bostang/PSoC6/README.md

# PSoC6
 Repository untuk program yang dijalankan pada PSoC6 (belajar dan hands-on project)

## Pranala Penting

[Hardware Abstraction Layer (HAL)](https://infineon.github.io/psoc6hal/html/index.html)
