bostang/PSoC6/Notes/1.md

1. Untuk membantu mempelajari konsep pemrograman PSoC, kita bisa bisa juga membaca file-file yang ada yang secara otomatis terbentuk / di example

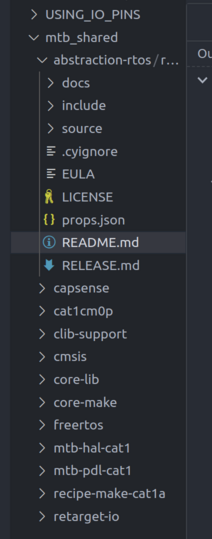
[picture p18: Notes/image/1/1701488007020.png]
direktori projek


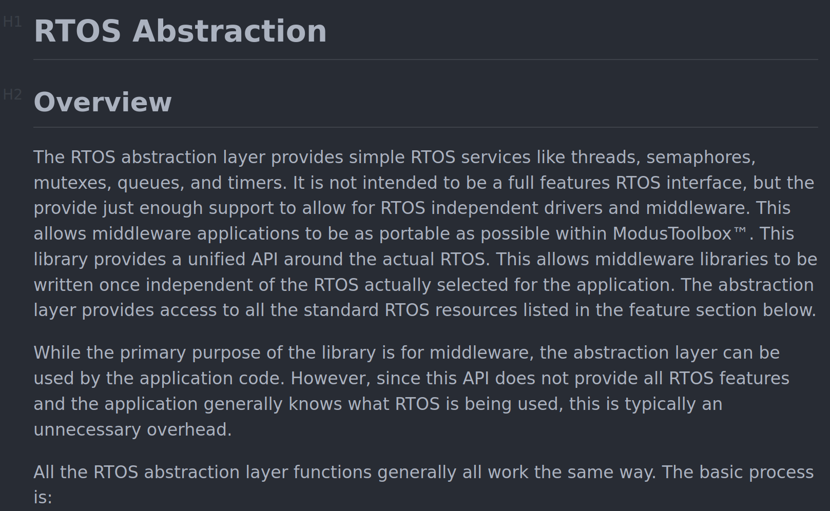
[picture p19: Notes/image/1/1701488026996.png]
README.md dari salah satu folder yang terbentuk


2. sedikit trick untuk convert size image : `

```
convert -resize 20% source.png dest.jpg
```

3. workflow yang lumayan efektif

ketika melihat dokumen-dokumen seperti user-manual, lebih enak diilihat di pdf viewer di VScode ketimbang di browser --> kebanyakan tab dan harus buka **My documents** dulu untuk ngebuka pdfnya.

4. Cara cepat untuk build sekaligus flash program ke PSoC

Pada direktori (_workspace_) yang dibuat, buka terminal lalu ketikkan:
```
make program
```
5. Dalam melakukan pengembangan kode, upayakan untuk menggunakan `MACRO`. Usahakan tidak ada angka pada tengah-tengah kode. Deklarasikan semua `MACRO` di awal.

6. Pengembangan kode dengan PSoC memiliki alur kembangkan dari _example_ yang ada, sesuaikan dengan kebutuhan kita berdasarkan referensi [HAL API](https://infineon.github.io/psoc6hal/html/index.html) dan gunakan bantuan [ChatGPT](chat.openai.com/chat) agar proses pengembangan lebih efektif dan mengurangi kebingunan.

7. _common pattern_ yang diamati untuk melakukan suatu proses sambil error handling
```
    if (CY_RSLT_SUCCESS == <PROSES>)
    {
        handle_error();
    }
```
contoh :
```
if (CY_RSLT_SUCCESS == cyhal_uart_getc(&cy_retarget_io_uart_obj, &read_data, 0))
    if (result != CY_RSLT_SUCCESS)
    {
        handle_error();
    }
```

8. selalu melakukan _error handling_ ketika inisiasi
```
result = cybsp_init();
if (result != CY_RSLT_SUCCESS)
{
    handle_error();
}

result = cyhal_uart_init(&uart_obj_barcode, pin_barcode_tx, pin_barcode_rx,NC,NC, NULL, NULL);
if (result != CY_RSLT_SUCCESS)
{
    handle_error();
}
```
9. Apabila melakukan _development_ di Eclipse IDE (windows), Untuk menggunakan terminal, kita tidak perlu menggunakan aplikasi eksternal seperty Putty ataupun TeraTerm, tetapi bisa menggunakan terminal yang ada di Modus toolbox sendiri.

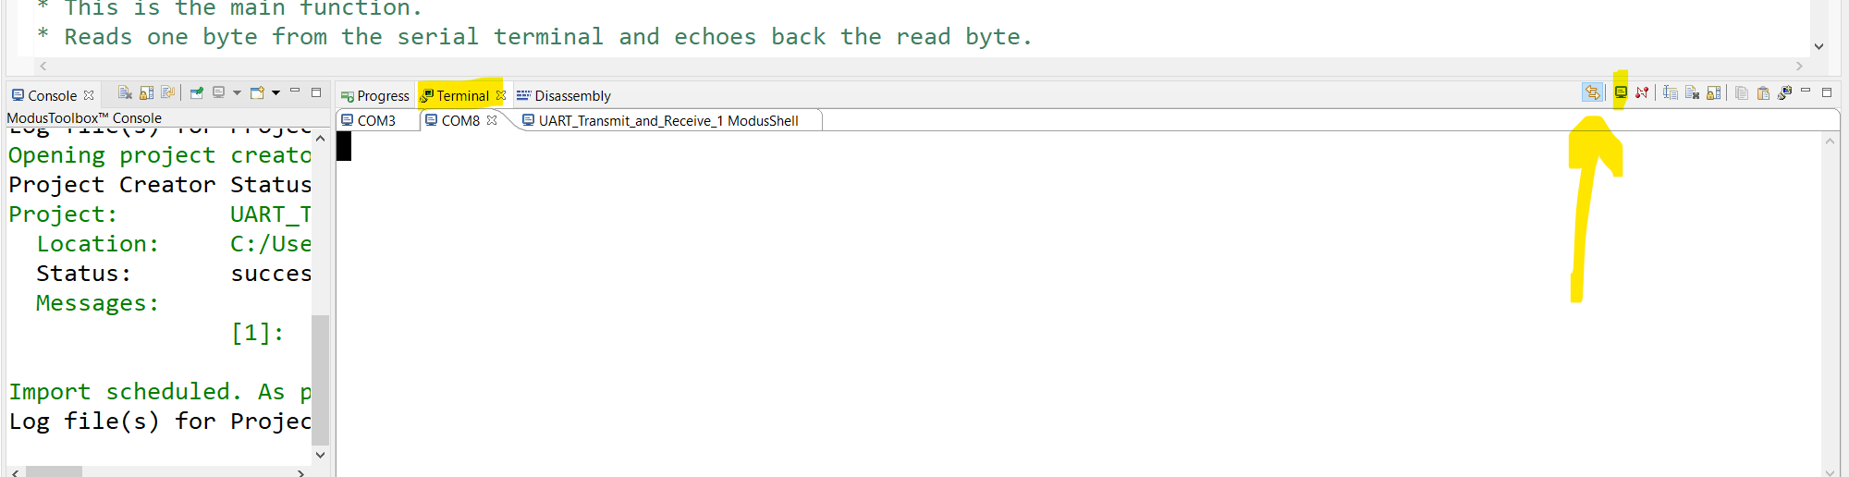
[picture p20: Notes/image/1/prompt_terminal_modus_toolbox.png]
Foto terminal MTB
