bostang/PSoC6/Development/YR903_RFID_module_dev/images/host_packet_definition.png

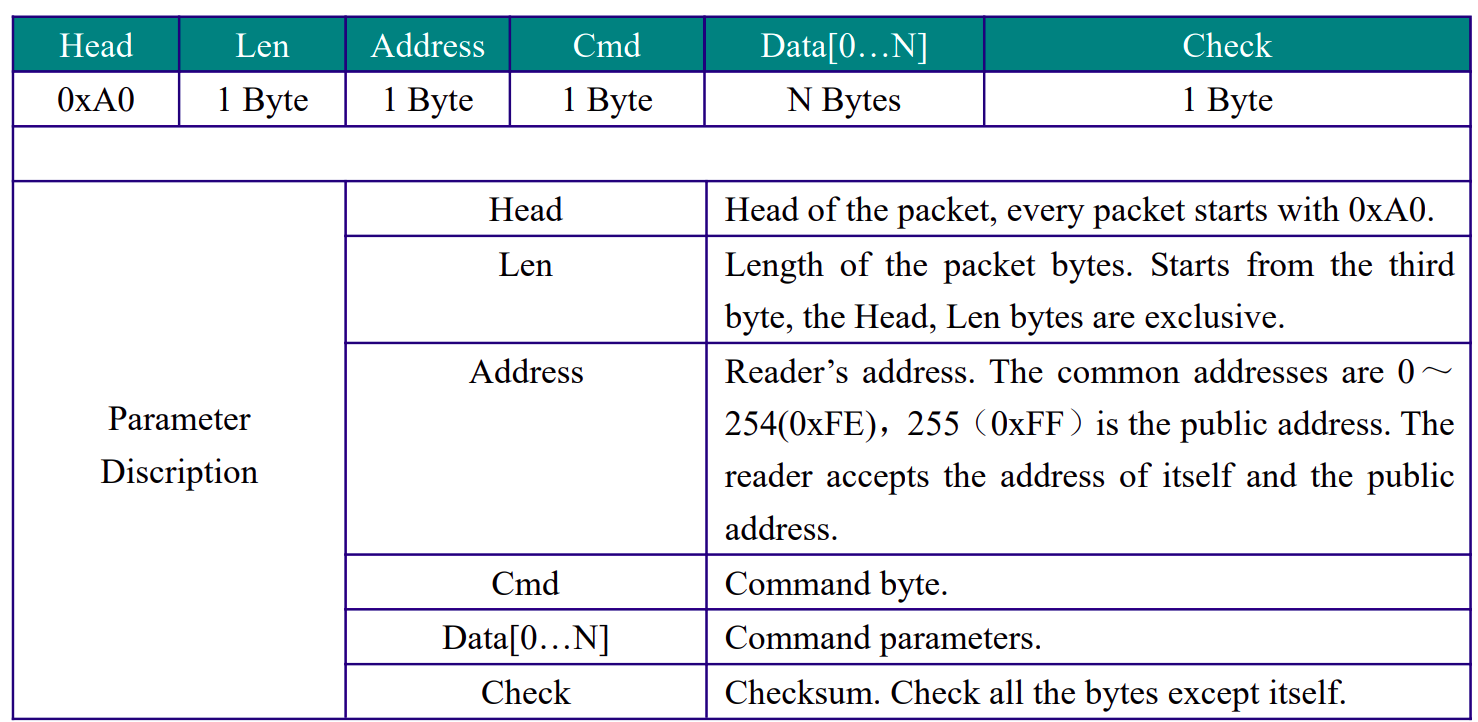
Development/YR903_RFID_module_dev/images/host_packet_definition.png
