bostang/PSoC6/Development/YR903_RFID_module_dev/images/response_packet_definition.png

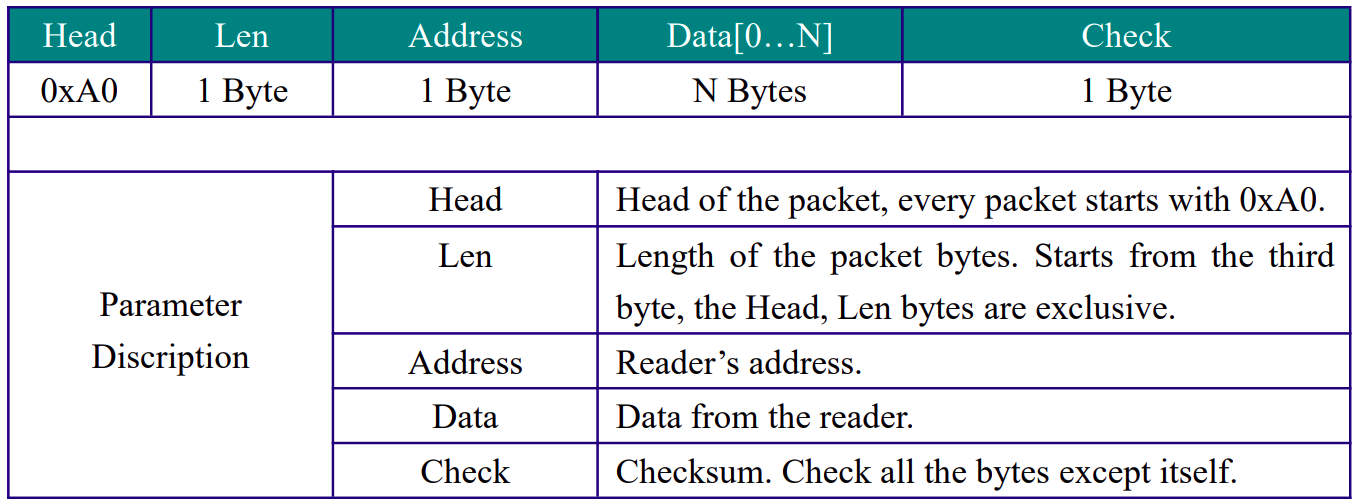
Development/YR903_RFID_module_dev/images/response_packet_definition.png
