bostang/PSoC6/Development/YR903_RFID_module_dev/images/sukses_kirim_ke_terminal.png

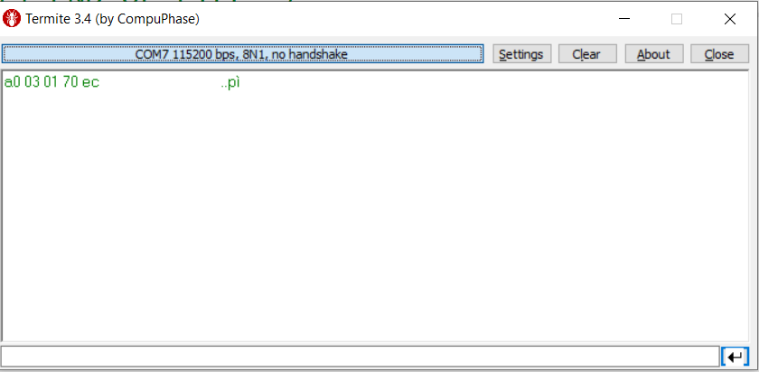
Development/YR903_RFID_module_dev/images/sukses_kirim_ke_terminal.png
