bostang/PSoC6/PCB/3d models/Button Cap Front.png

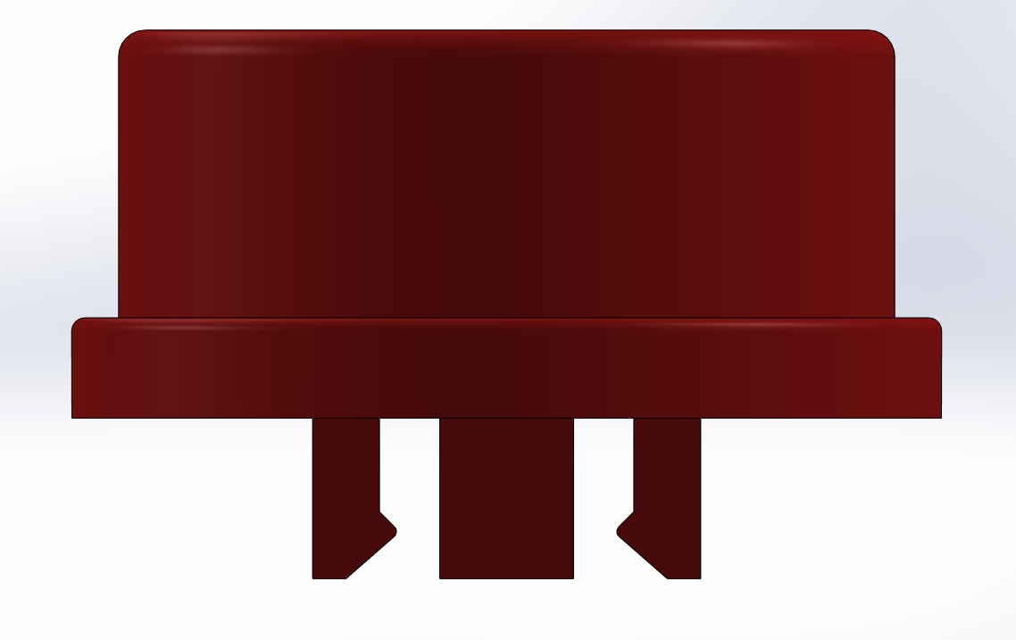
PCB/3d models/Button Cap Front.png
