bostang/PSoC6/PCB/3d models/Button Cap Isometric.png

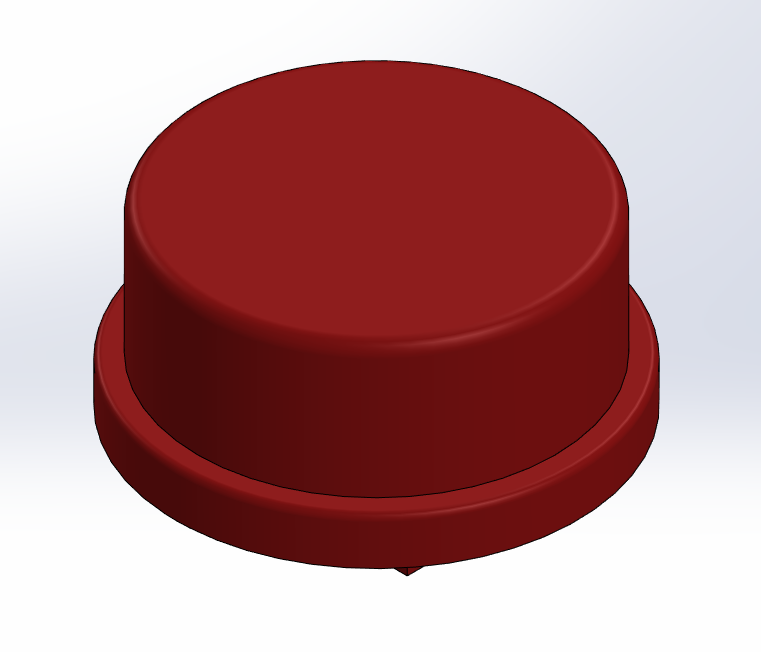
PCB/3d models/Button Cap Isometric.png
