bostang/PSoC6/PCB/3d models/Button Cap Side.png

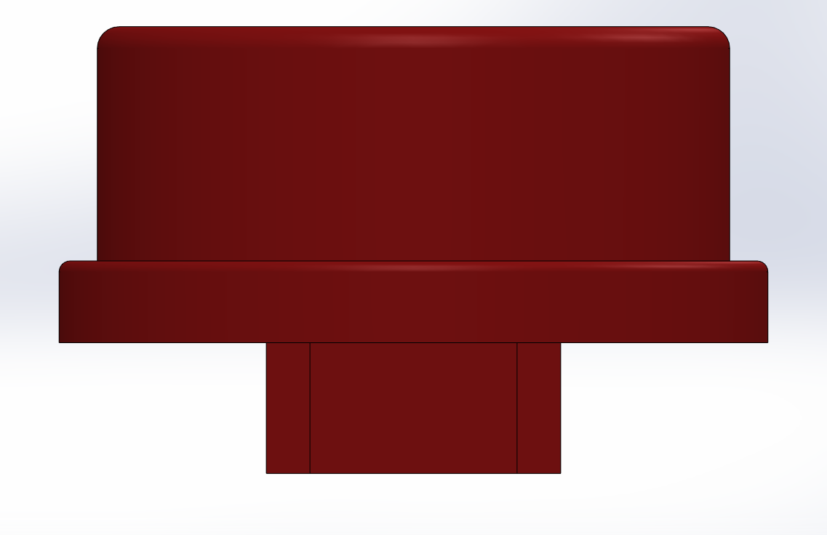
PCB/3d models/Button Cap Side.png
