bostang/PSoC6/PCB/3d models/Button Front.png

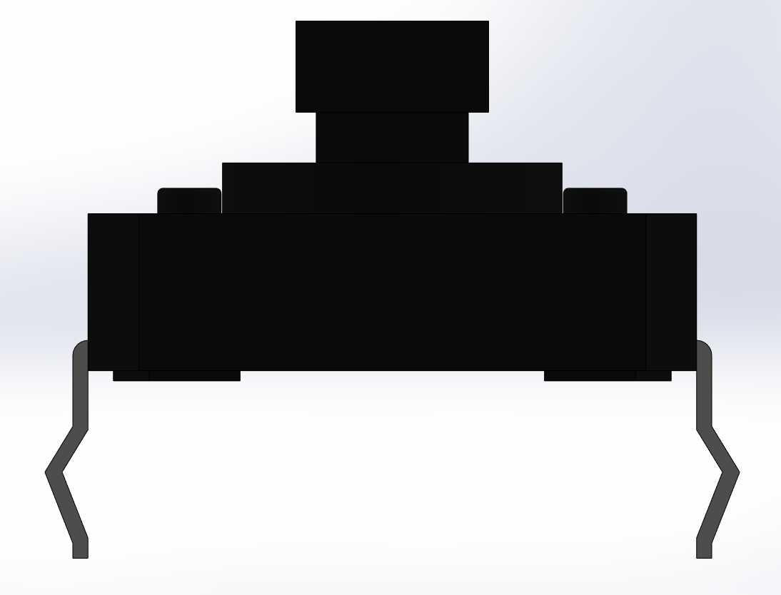
PCB/3d models/Button Front.png
