bostang/PSoC6/PCB/3d models/Button Isometric.png

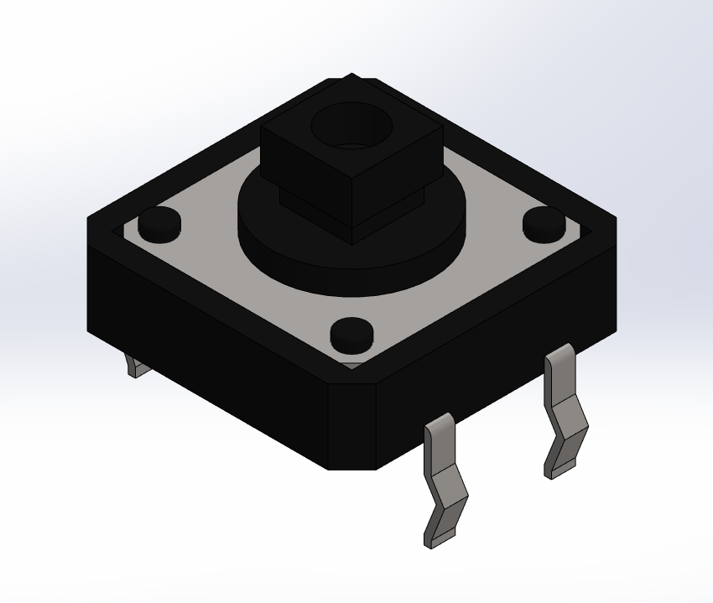
PCB/3d models/Button Isometric.png
