bostang/PSoC6/PCB/3d models/Button Side.png

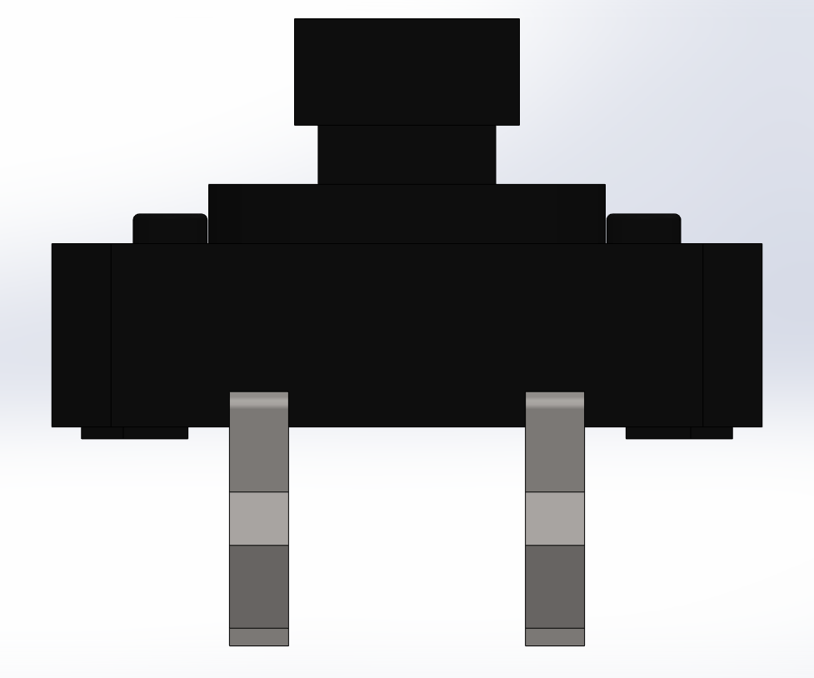
PCB/3d models/Button Side.png
