bostang/PSoC6/PCB/3d models/Button with Cap Front.png

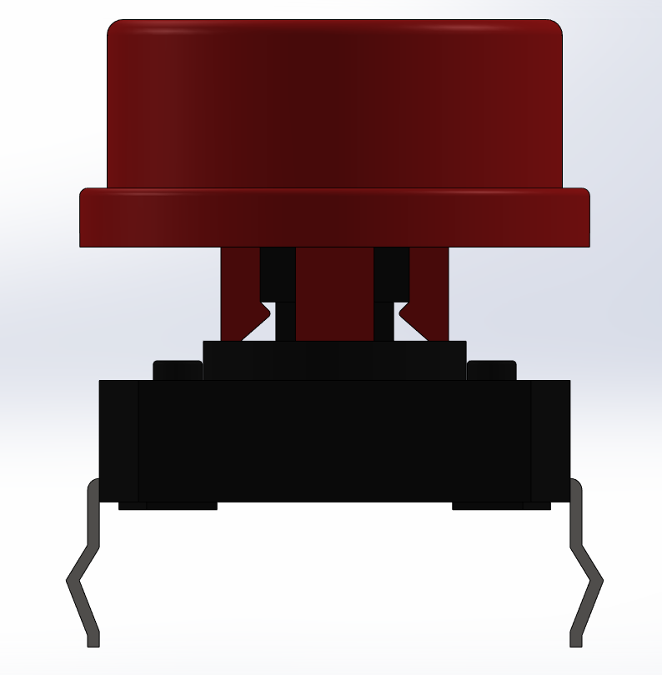
PCB/3d models/Button with Cap Front.png
