bostang/PSoC6/PCB/3d models/Button with Cap Side.png

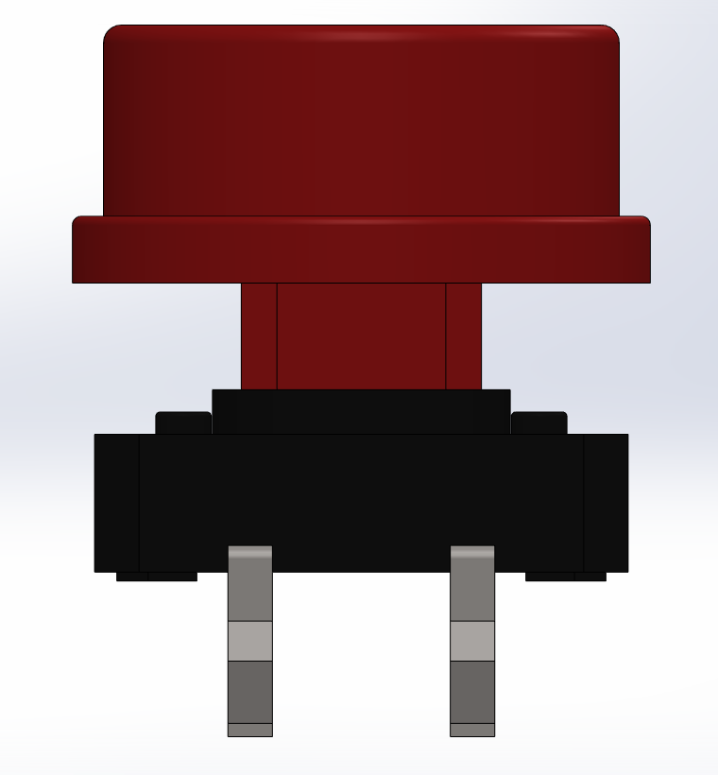
PCB/3d models/Button with Cap Side.png
