bostang/PSoC6/PCB/img/stei-itb.jpeg

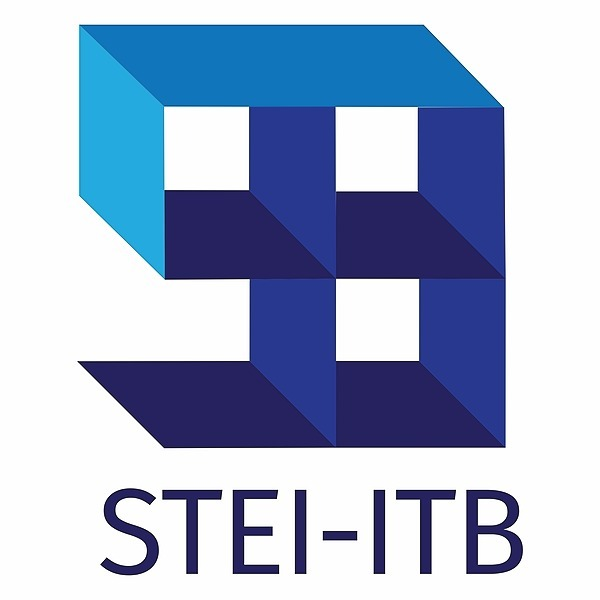
PCB/img/stei-itb.jpeg
