bostang/PSoC6/PCB/3d models/BMxxB-SRSR-TB/BM02B-SRSS-TB.STEP

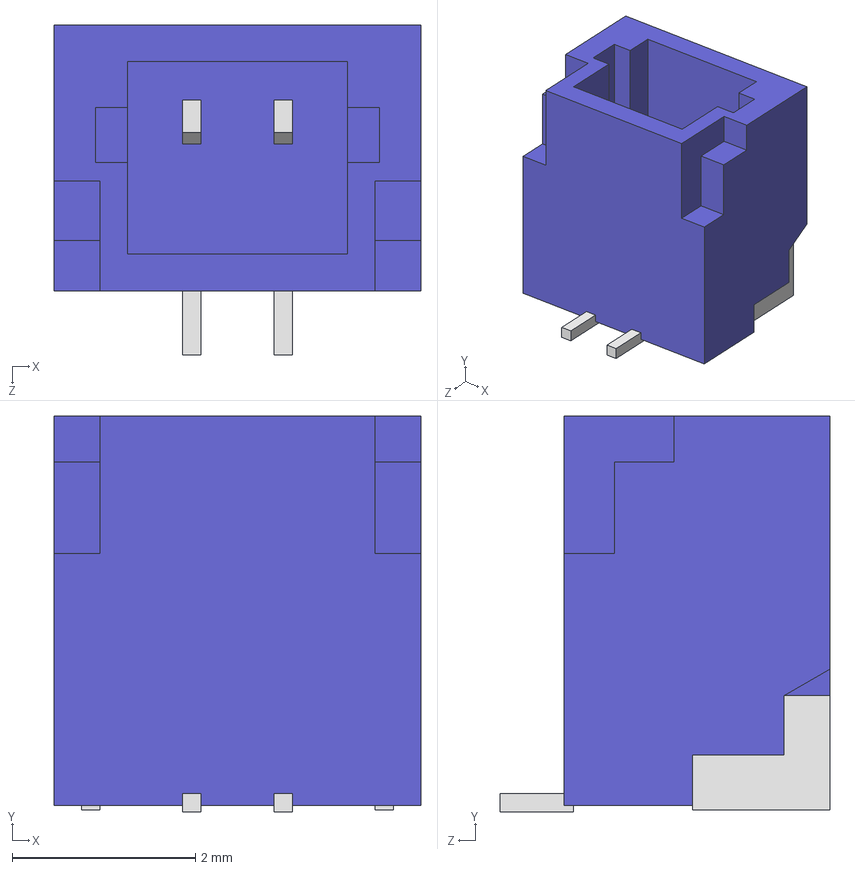
[picture p33: CAD file, 2024-04-19]
PCB/3d models/BMxxB-SRSR-TB/BM02B-SRSS-TB.STEP
4.00 x 4.32 x 3.60 mm
