bostang/PSoC6/PCB/3d models/FFC/2-1734592-0.stp

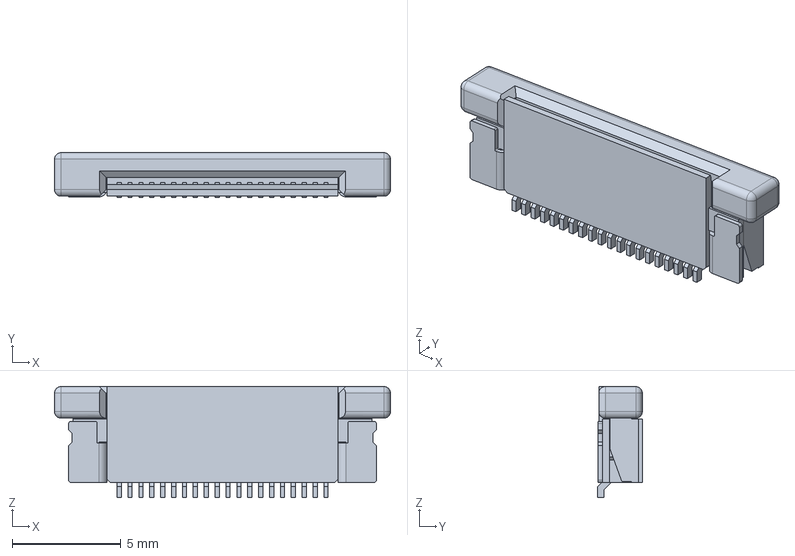
[picture p34: CAD file, 2024-04-19]
PCB/3d models/FFC/2-1734592-0.stp
15.4 x 2.05 x 5.11 mm
