bostang/PSoC6/PCB/3d models/FreeCAD Files/Set.FCStd

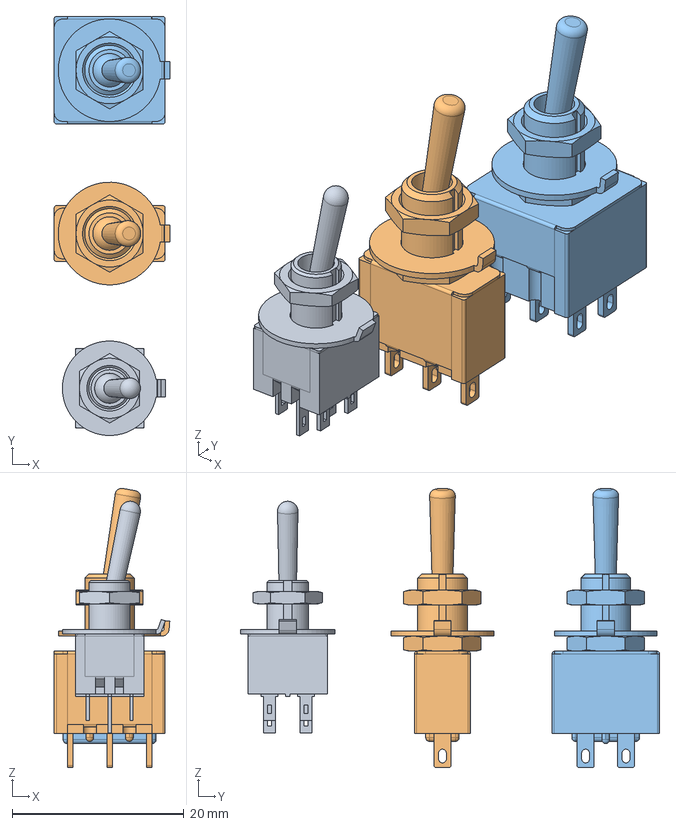
[picture p35: CAD file, 2024-04-19]
PCB/3d models/FreeCAD Files/Set.FCStd
13.4 x 48.7 x 32.5 mm
5mm DPDT Mini Toggle Switch_001
6mm SPDT Mini Toggle Switch_001
6mm DPDT Mini Toggle Switch_001
