bostang/PSoC6/PCB/3d models/SMxxB-SRSS-TB/SM12B-SRSS-TB.STEP

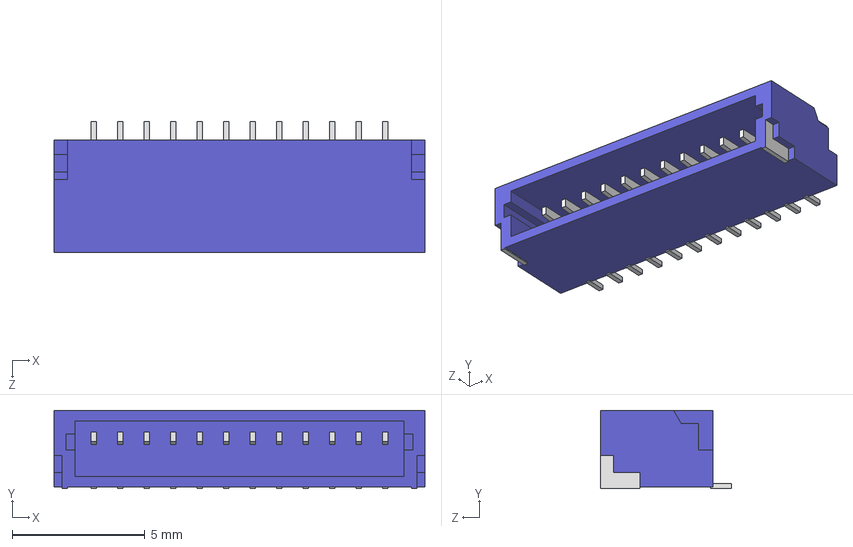
[picture p38: CAD file, 2024-04-19]
PCB/3d models/SMxxB-SRSS-TB/SM12B-SRSS-TB.STEP
14.0 x 2.96 x 4.95 mm
