bostang/PSoC6/PCB/3d models/SSH-003T-P0.2-H/SSH-003T-P0.2-H.STEP

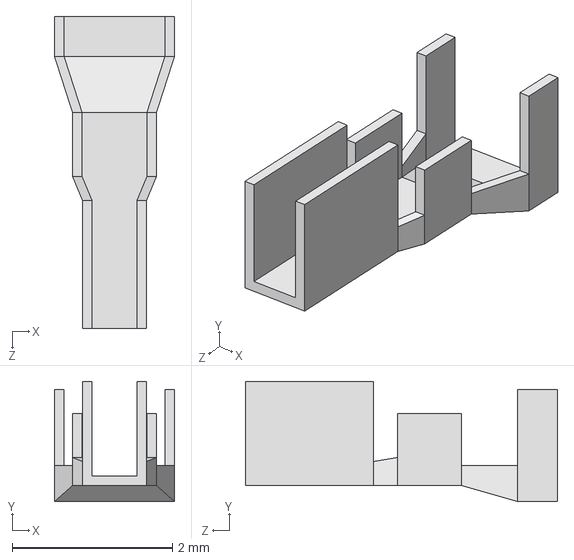
[picture p39: CAD file, 2024-04-19]
PCB/3d models/SSH-003T-P0.2-H/SSH-003T-P0.2-H.STEP
1.50 x 1.50 x 3.90 mm
