bostang/PSoC6/PCB/3d models/BMxxB-SRSR-TB/BM08B-SRSS-TB.STEP

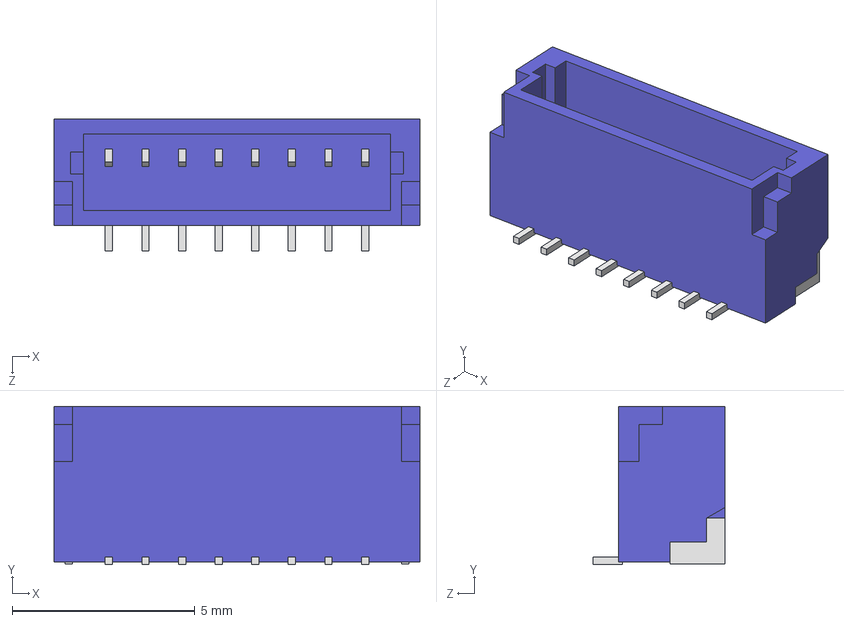
[picture p40: CAD file, 2024-04-19]
PCB/3d models/BMxxB-SRSR-TB/BM08B-SRSS-TB.STEP
10.0 x 4.32 x 3.60 mm
