bostang/PSoC6/PCB/3d models/SHR-xxV-S-B/SHR-06V-S-B.STEP

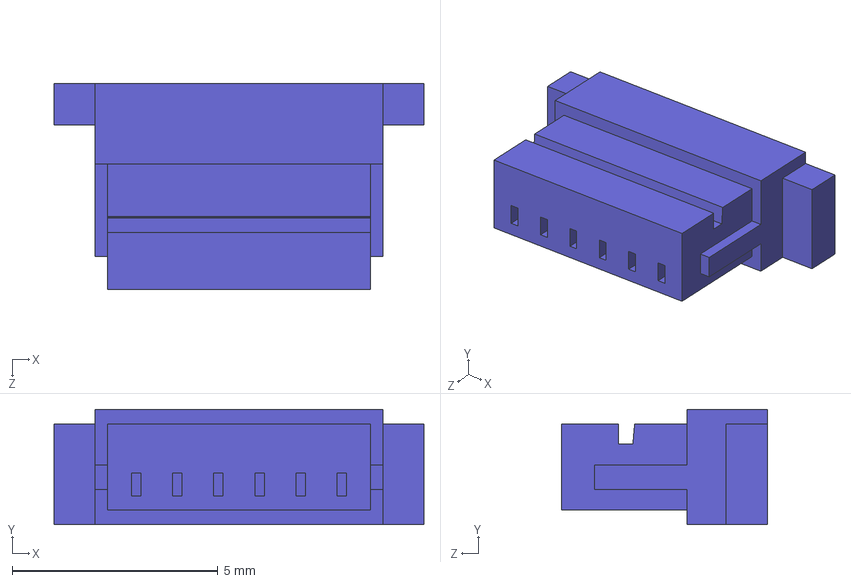
[picture p41: CAD file, 2024-04-19]
PCB/3d models/SHR-xxV-S-B/SHR-06V-S-B.STEP
9.00 x 2.80 x 5.00 mm
