bostang/PSoC6/PCB/3d models/SHR-xxV-S/SHR-13V-S.STEP

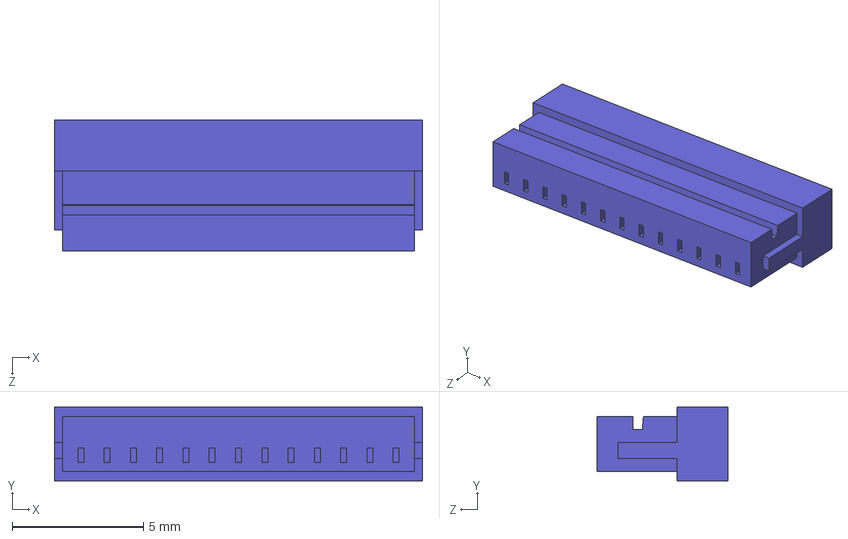
[picture p42: CAD file, 2024-04-19]
PCB/3d models/SHR-xxV-S/SHR-13V-S.STEP
14.0 x 2.80 x 5.00 mm
