bostang/PSoC6/PCB/3d models/5mm DPDT Mini Toggle Switch.step

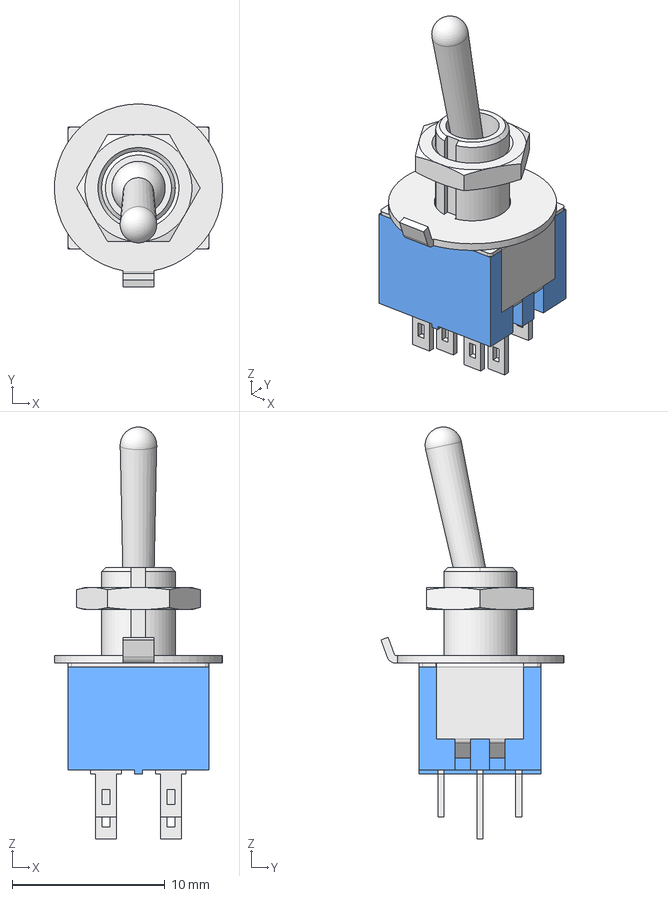
[picture p45: CAD file, 2024-04-19]
PCB/3d models/5mm DPDT Mini Toggle Switch.step
11.0 x 12.0 x 26.9 mm
