bostang/PSoC6/PCB/3d models/BMxxB-SRSR-TB/BM12B-SRSS-TB.STEP

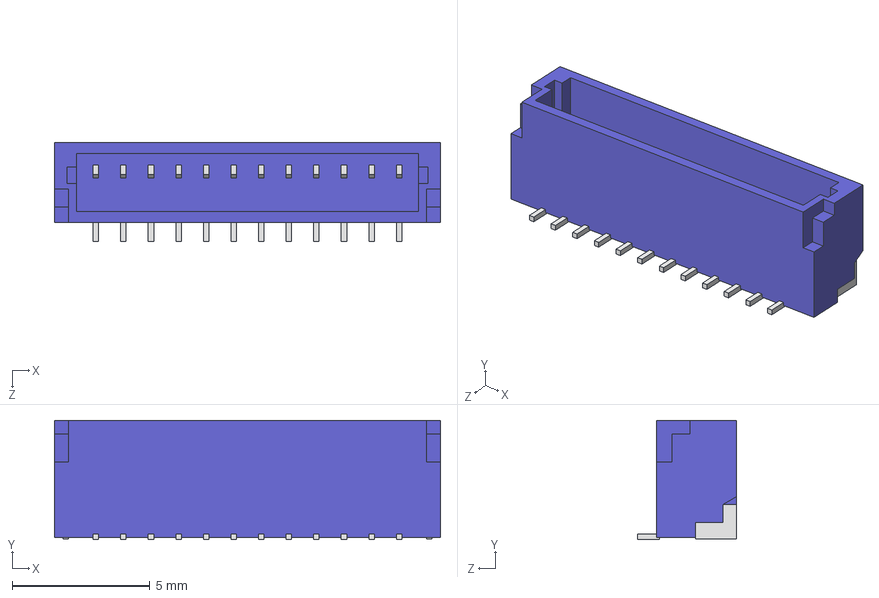
[picture p46: CAD file, 2024-04-19]
PCB/3d models/BMxxB-SRSR-TB/BM12B-SRSS-TB.STEP
14.0 x 4.32 x 3.60 mm
