bostang/PSoC6/PCB/3d models/SHR-xxV-S/SHR-12V-S.STEP

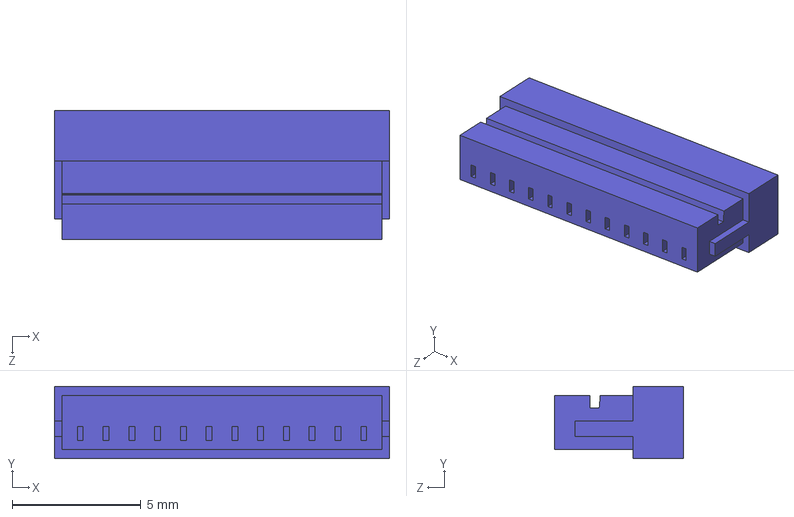
[picture p48: CAD file, 2024-04-19]
PCB/3d models/SHR-xxV-S/SHR-12V-S.STEP
13.0 x 2.80 x 5.00 mm
