bostang/PSoC6/PCB/3d models/SMxxB-SRSS-TB/SM06B-SRSS-TB.STEP

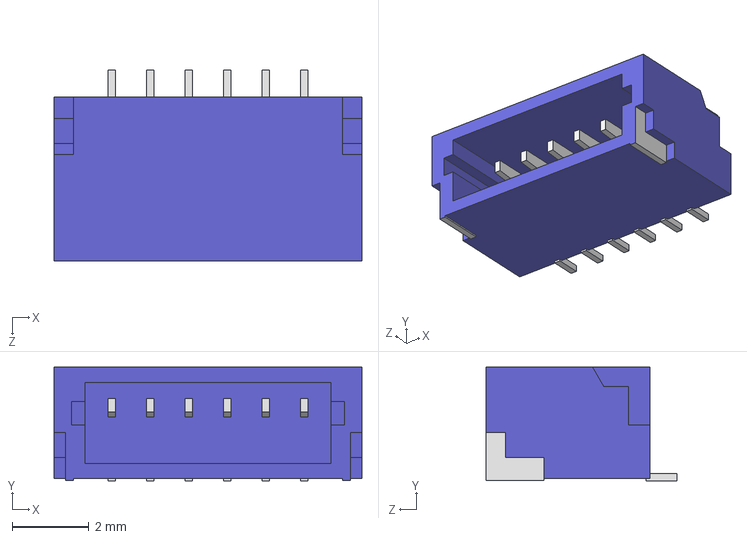
[picture p49: CAD file, 2024-04-19]
PCB/3d models/SMxxB-SRSS-TB/SM06B-SRSS-TB.STEP
8.00 x 2.96 x 4.95 mm
