bostang/PSoC6/PCB/3d models/6mm SPDT Mini Toggle Switch.step

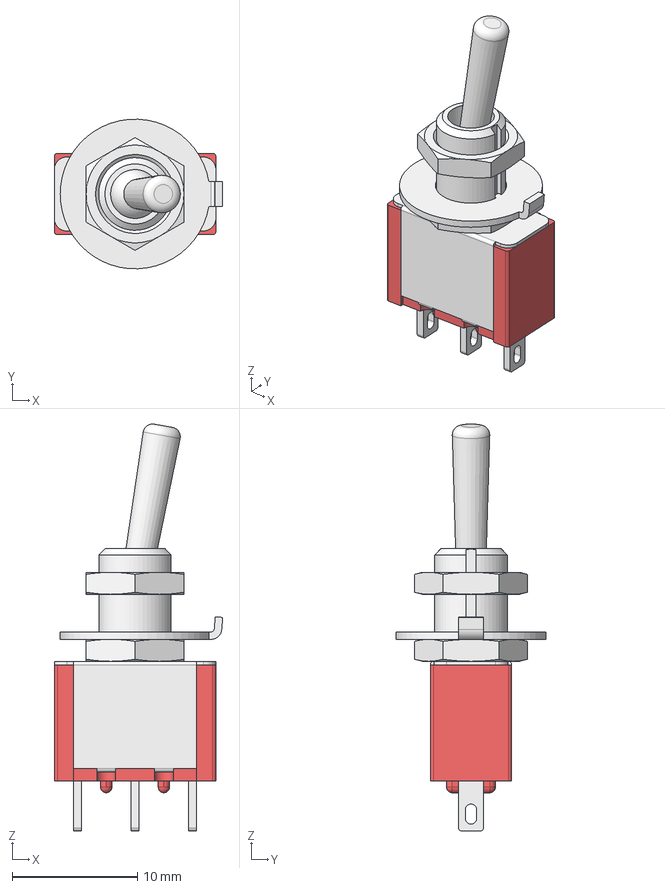
[picture p50: CAD file, 2024-04-19]
PCB/3d models/6mm SPDT Mini Toggle Switch.step
13.4 x 11.9 x 32.5 mm
