bostang/PSoC6/PCB/3d models/BMxxB-SRSR-TB/BM07B-SRSS-TB.STEP

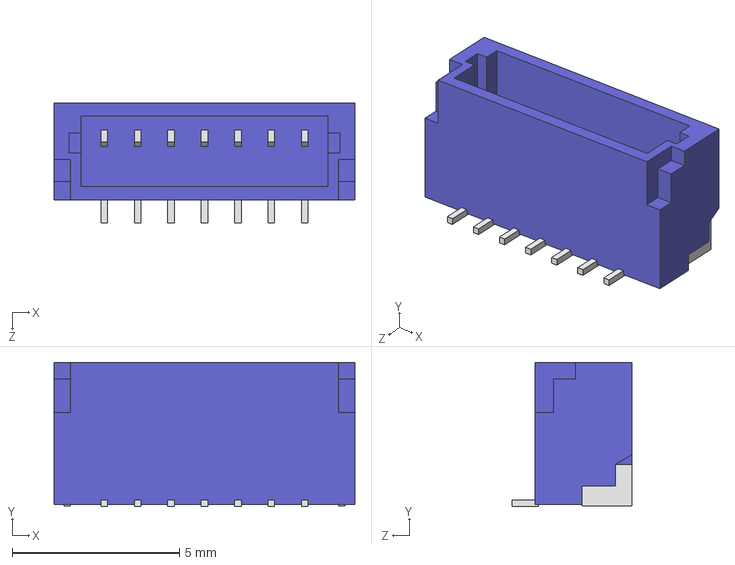
[picture p51: CAD file, 2024-04-19]
PCB/3d models/BMxxB-SRSR-TB/BM07B-SRSS-TB.STEP
9.00 x 4.32 x 3.60 mm
