bostang/PSoC6/PCB/3d models/SHR-xxV-S-B/SHR-14V-S-B.STEP

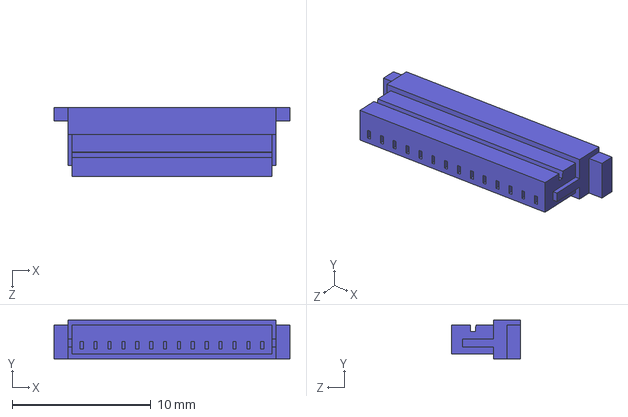
[picture p52: CAD file, 2024-04-19]
PCB/3d models/SHR-xxV-S-B/SHR-14V-S-B.STEP
17.0 x 2.80 x 5.00 mm
