bostang/PSoC6/PCB/3d models/SHR-xxV-S/SHR-03V-S.STEP

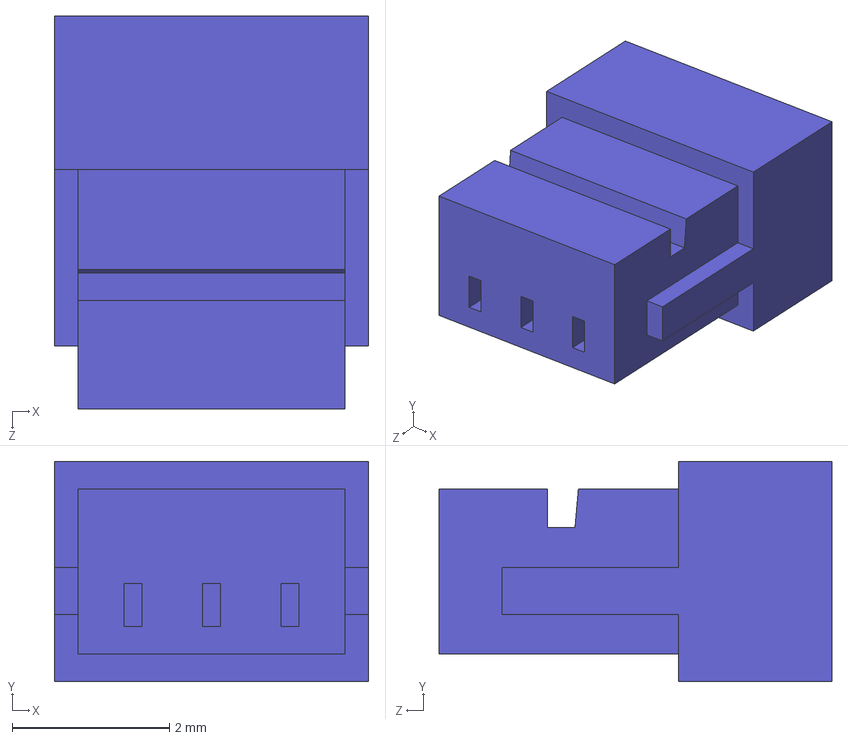
[picture p53: CAD file, 2024-04-19]
PCB/3d models/SHR-xxV-S/SHR-03V-S.STEP
4.00 x 2.80 x 5.00 mm
