bostang/PSoC6/PCB/3d models/6mm DPDT Mini Toggle Switch.step

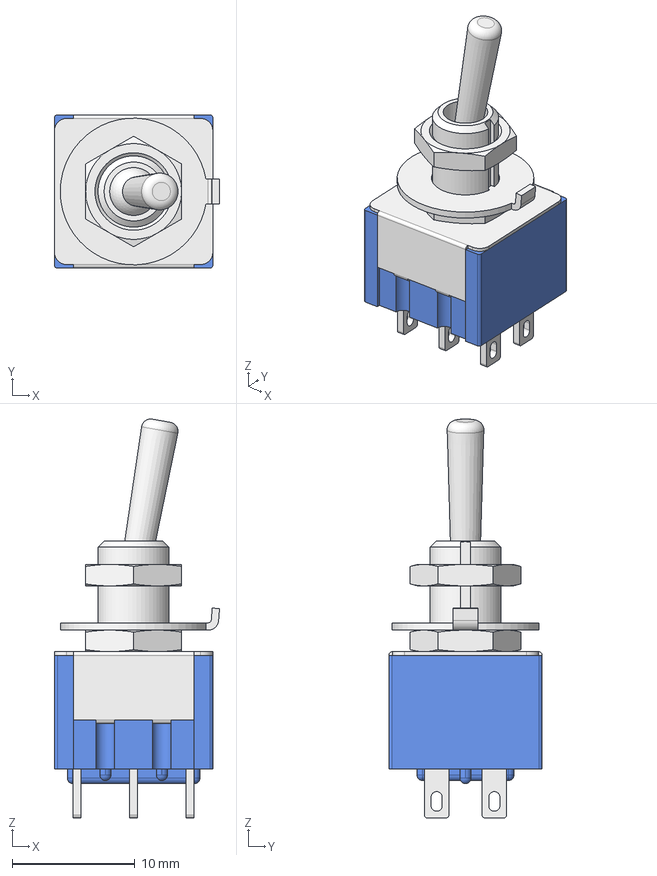
[picture p55: CAD file, 2024-04-19]
PCB/3d models/6mm DPDT Mini Toggle Switch.step
13.4 x 12.5 x 32.5 mm
