bostang/PSoC6/PCB/3d models/BMxxB-SRSR-TB/BM06B-SRSS-TB.STEP

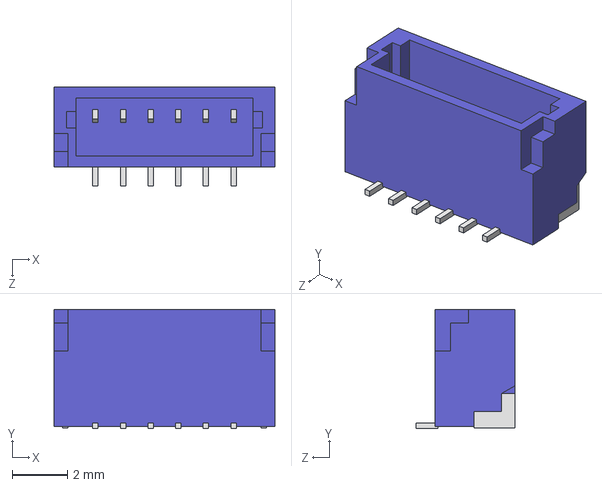
[picture p56: CAD file, 2024-04-19]
PCB/3d models/BMxxB-SRSR-TB/BM06B-SRSS-TB.STEP
8.00 x 4.32 x 3.60 mm
