bostang/PSoC6/PCB/3d models/SHR-xxV-S-B/SHR-10V-S-B.STEP

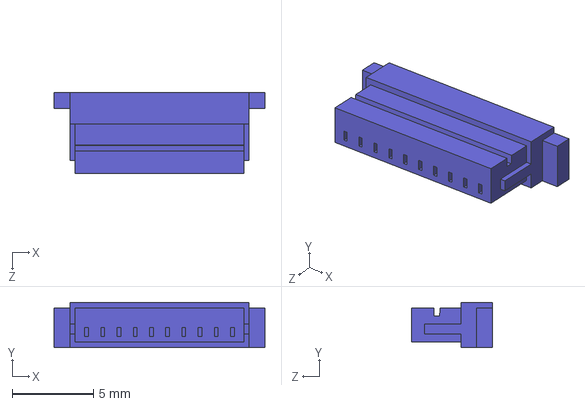
[picture p57: CAD file, 2024-04-19]
PCB/3d models/SHR-xxV-S-B/SHR-10V-S-B.STEP
13.0 x 2.80 x 5.00 mm
