bostang/PSoC6/PCB/3d models/SHR-xxV-S/SHR-09V-S.STEP

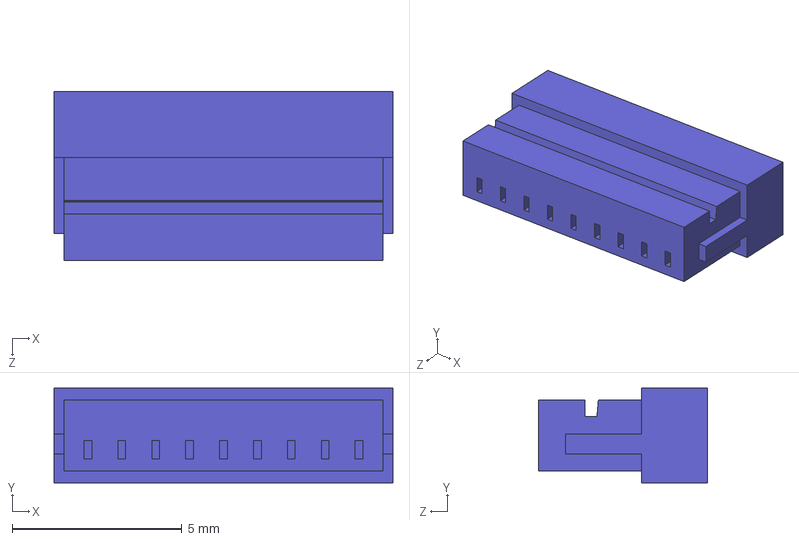
[picture p58: CAD file, 2024-04-19]
PCB/3d models/SHR-xxV-S/SHR-09V-S.STEP
10.0 x 2.80 x 5.00 mm
