bostang/PSoC6/PCB/3d models/SMxxB-SRSS-TB/SM02B-SRSS-TB.STEP

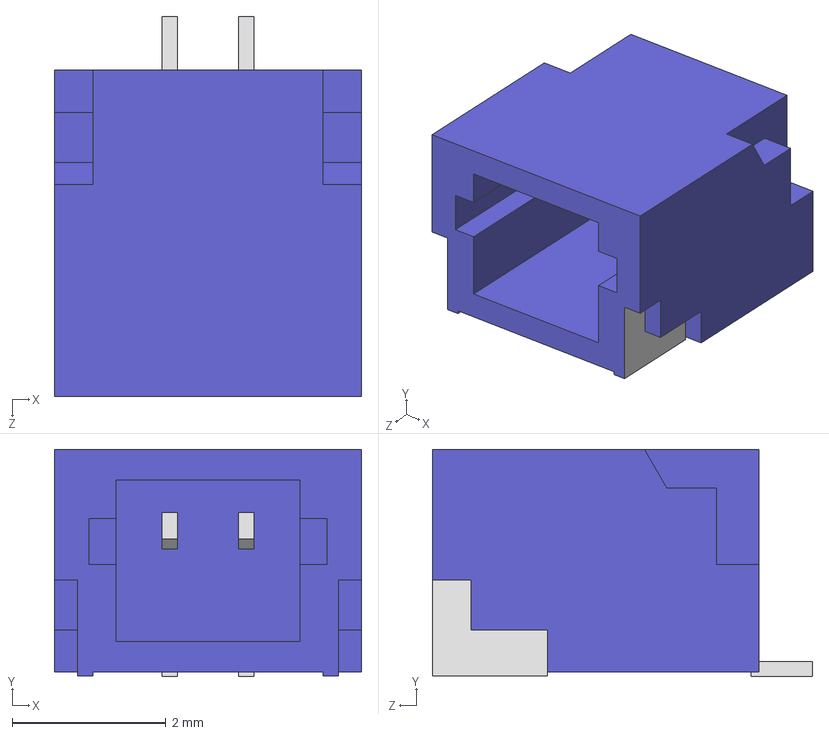
[picture p59: CAD file, 2024-04-19]
PCB/3d models/SMxxB-SRSS-TB/SM02B-SRSS-TB.STEP
4.00 x 2.96 x 4.95 mm
