bostang/PSoC6/PCB/3d models/12mm Push Button with Cap.STEP

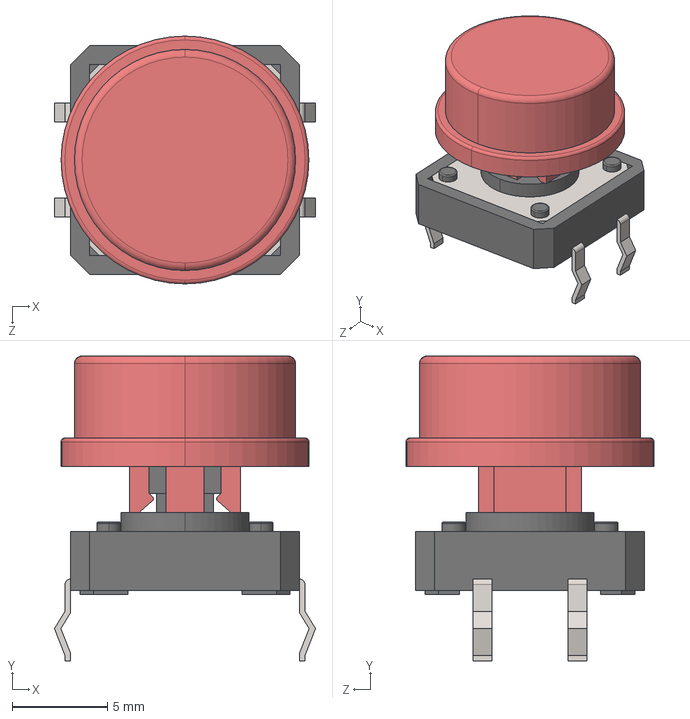
[picture p60: CAD file, 2024-03-14]
PCB/3d models/12mm Push Button with Cap.STEP
13.7 x 16.0 x 13.0 mm
12mm Push Button
12mm Push Button Cap
