bostang/PSoC6/PCB/3d models/BMxxB-SRSR-TB/BM10B-SRSS-TB.STEP

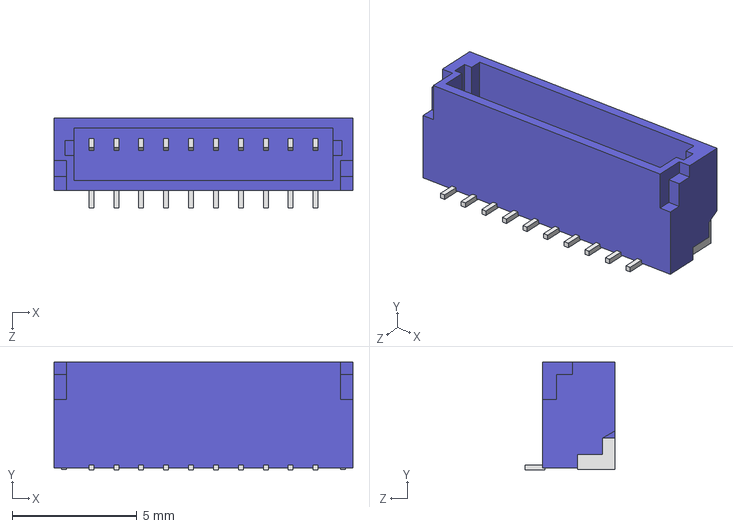
[picture p61: CAD file, 2024-04-19]
PCB/3d models/BMxxB-SRSR-TB/BM10B-SRSS-TB.STEP
12.0 x 4.32 x 3.60 mm
