bostang/PSoC6/PCB/3d models/SHR-xxV-S-B/SHR-12V-S-B.STEP

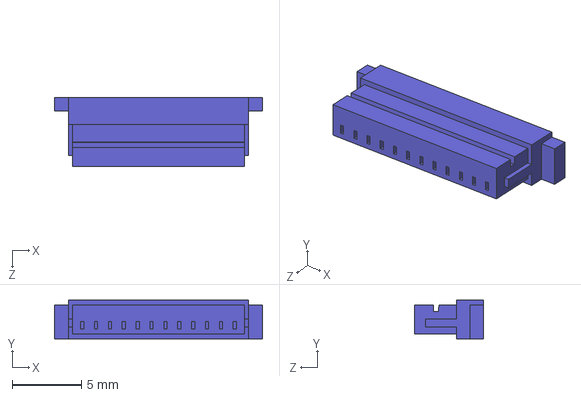
[picture p62: CAD file, 2024-04-19]
PCB/3d models/SHR-xxV-S-B/SHR-12V-S-B.STEP
15.0 x 2.80 x 5.00 mm
