bostang/PSoC6/PCB/3d models/SMxxB-SRSS-TB/SM09B-SRSS-TB.STEP

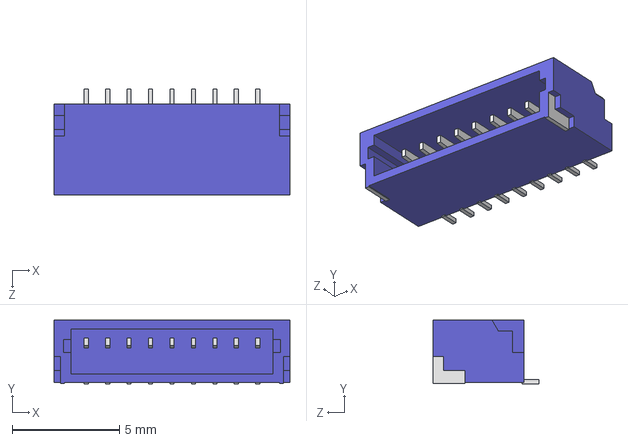
[picture p64: CAD file, 2024-04-19]
PCB/3d models/SMxxB-SRSS-TB/SM09B-SRSS-TB.STEP
11.0 x 2.96 x 4.95 mm
