bostang/PSoC6/PCB/3d models/Hold_18650-1p_smd.stp

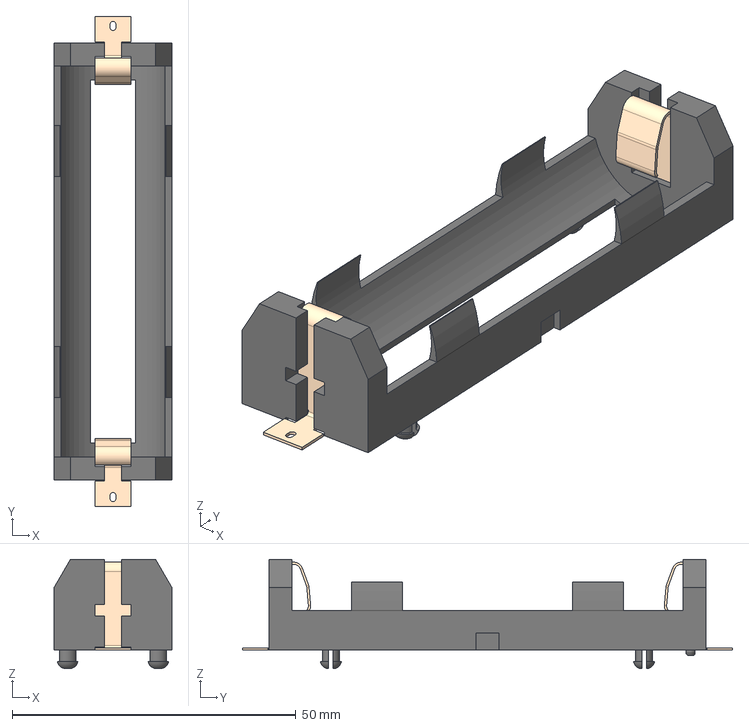
[picture p66: CAD file, 2024-03-14]
PCB/3d models/Hold_18650-1p_smd.stp
20.8 x 86.4 x 19.3 mm
