bostang/PSoC6/PCB/3d models/SHR-xxV-S/SHR-15V-S.STEP

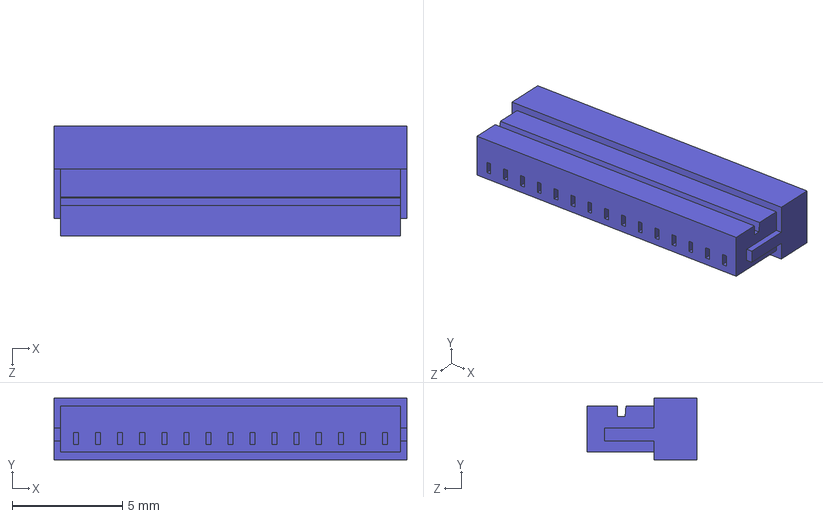
[picture p68: CAD file, 2024-04-19]
PCB/3d models/SHR-xxV-S/SHR-15V-S.STEP
16.0 x 2.80 x 5.00 mm
