bostang/PSoC6/PCB/3d models/BMxxB-SRSR-TB/BM15B-SRSS-TB.STEP

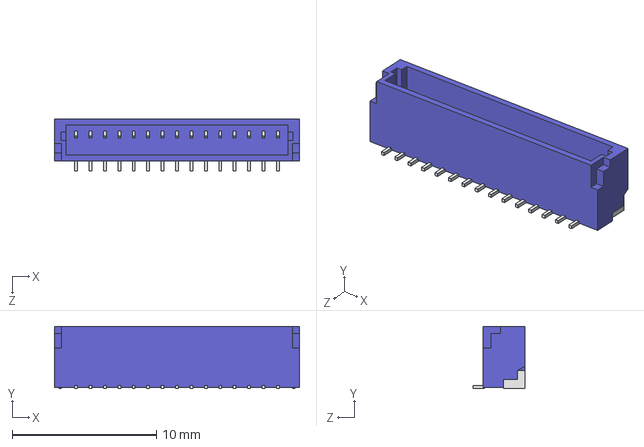
[picture p70: CAD file, 2024-04-19]
PCB/3d models/BMxxB-SRSR-TB/BM15B-SRSS-TB.STEP
17.0 x 4.32 x 3.60 mm
