bostang/PSoC6/PCB/3d models/SHR-xxV-S-B/SHR-20V-S-B.STEP

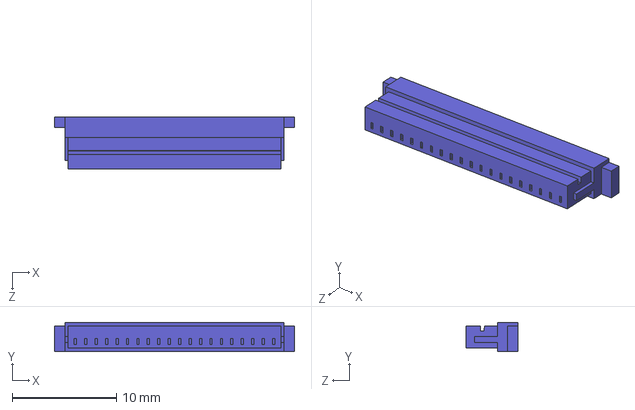
[picture p71: CAD file, 2024-04-19]
PCB/3d models/SHR-xxV-S-B/SHR-20V-S-B.STEP
23.0 x 2.80 x 5.00 mm
