bostang/PSoC6/PCB/3d models/SHR-xxV-S/SHR-05V-S.STEP

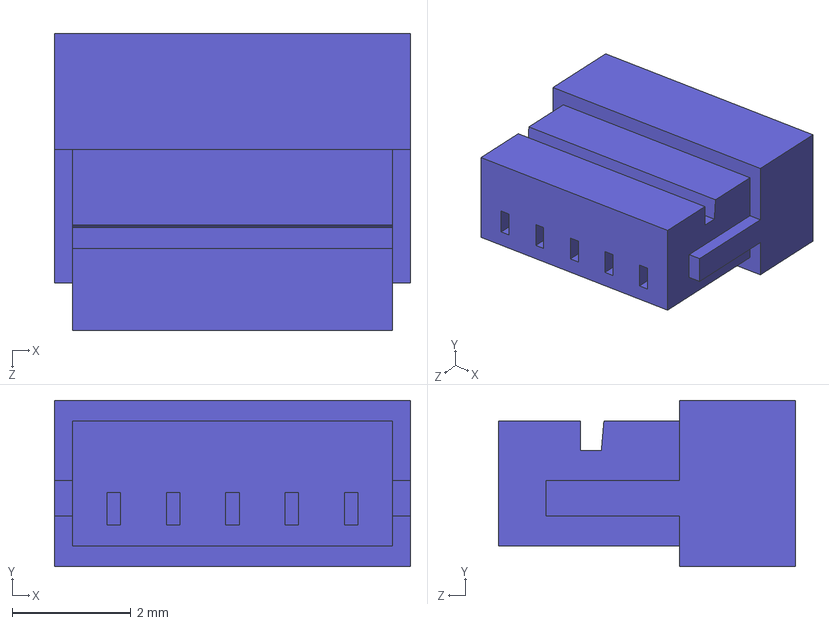
[picture p72: CAD file, 2024-04-19]
PCB/3d models/SHR-xxV-S/SHR-05V-S.STEP
6.00 x 2.80 x 5.00 mm
