bostang/PSoC6/PCB/3d models/SMxxB-SRSS-TB/SM11B-SRSS-TB.STEP

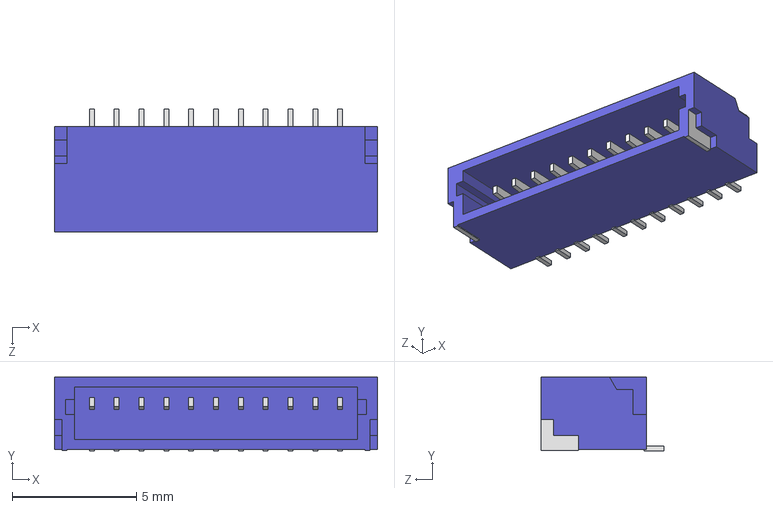
[picture p73: CAD file, 2024-04-19]
PCB/3d models/SMxxB-SRSS-TB/SM11B-SRSS-TB.STEP
13.0 x 2.96 x 4.95 mm
