bostang/PSoC6/PCB/3d models/MT3608 v3.step

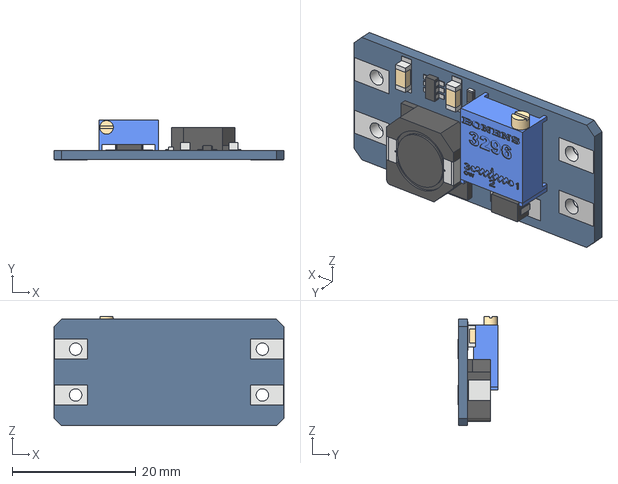
[picture p75: CAD file, 2024-03-14]
PCB/3d models/MT3608 v3.step
37.2 x 6.49 x 17.7 mm
