bostang/PSoC6/PCB/3d models/SHR-xxV-S/SHR-06V-S.STEP

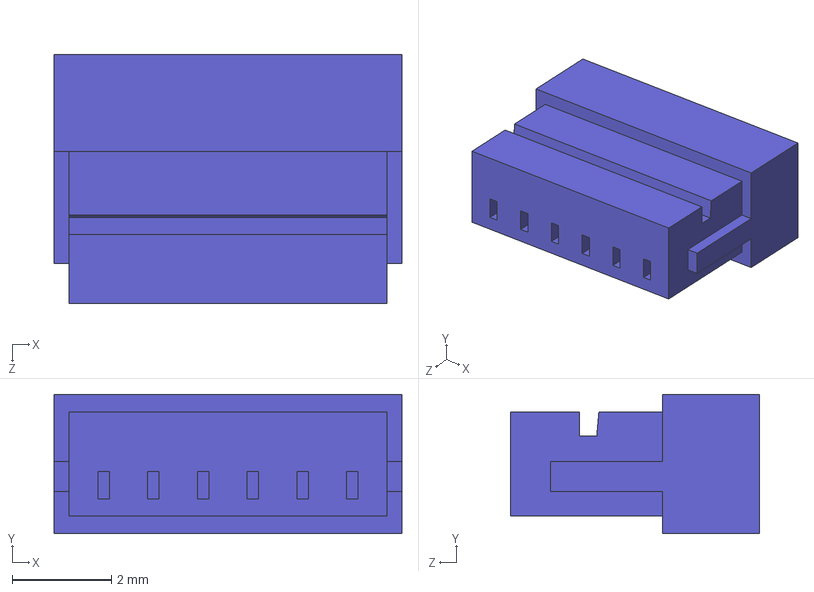
[picture p77: CAD file, 2024-04-19]
PCB/3d models/SHR-xxV-S/SHR-06V-S.STEP
7.00 x 2.80 x 5.00 mm
