bostang/PSoC6/PCB/3d models/12mm Push Button.STEP

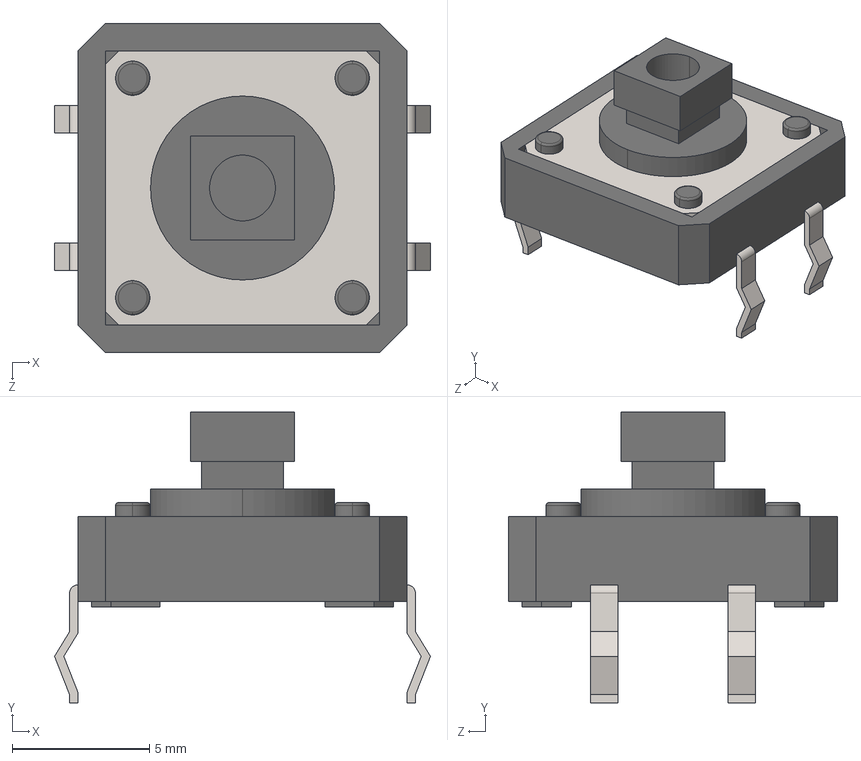
[picture p79: CAD file, 2024-03-14]
PCB/3d models/12mm Push Button.STEP
13.7 x 10.6 x 12.0 mm
