bostang/PSoC6/PCB/3d models/BMxxB-SRSR-TB/BM05B-SRSS-TB.STEP

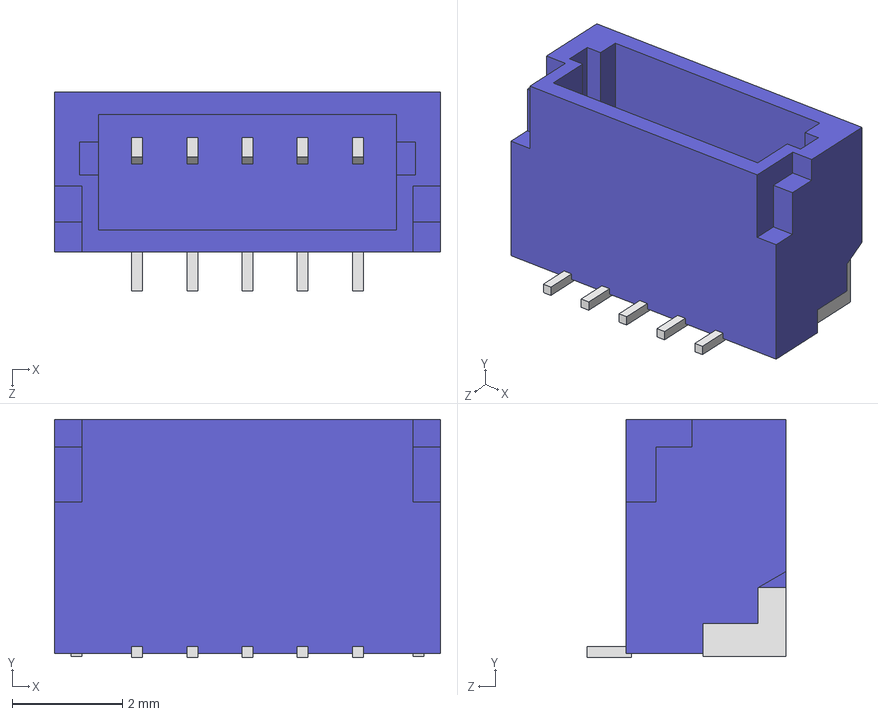
[picture p80: CAD file, 2024-04-19]
PCB/3d models/BMxxB-SRSR-TB/BM05B-SRSS-TB.STEP
7.00 x 4.32 x 3.60 mm
