bostang/PSoC6/PCB/3d models/SHR-xxV-S/SHR-11V-S.STEP

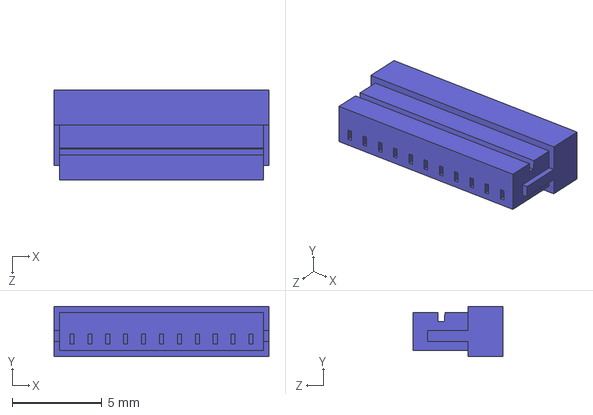
[picture p82: CAD file, 2024-04-19]
PCB/3d models/SHR-xxV-S/SHR-11V-S.STEP
12.0 x 2.80 x 5.00 mm
