bostang/PSoC6/PCB/3d models/SMxxB-SRSS-TB/SM07B-SRSS-TB.STEP

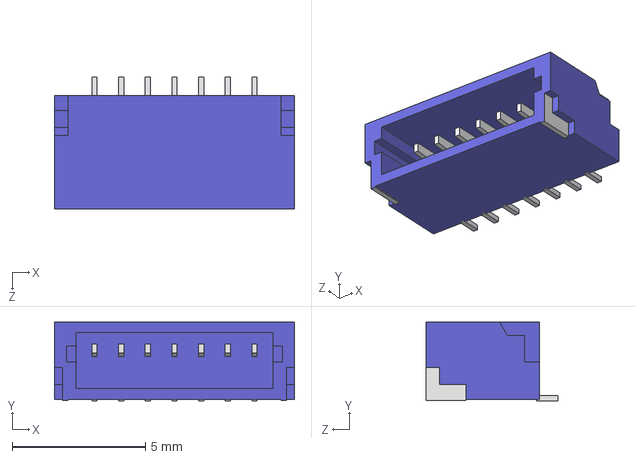
[picture p83: CAD file, 2024-04-19]
PCB/3d models/SMxxB-SRSS-TB/SM07B-SRSS-TB.STEP
9.00 x 2.96 x 4.95 mm
