bostang/PSoC6/PCB/3d models/12mm Push Button Cap.STEP

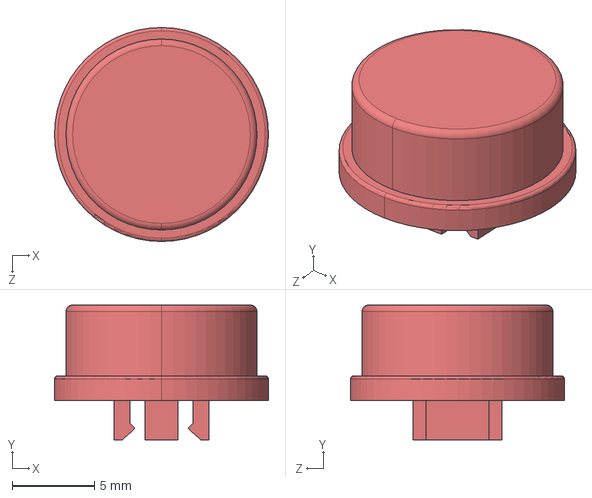
[picture p84: CAD file, 2024-03-14]
PCB/3d models/12mm Push Button Cap.STEP
13.0 x 8.20 x 13.0 mm
