bostang/PSoC6/PCB/3d models/SMxxB-SRSS-TB/SM03B-SRSS-TB.STEP

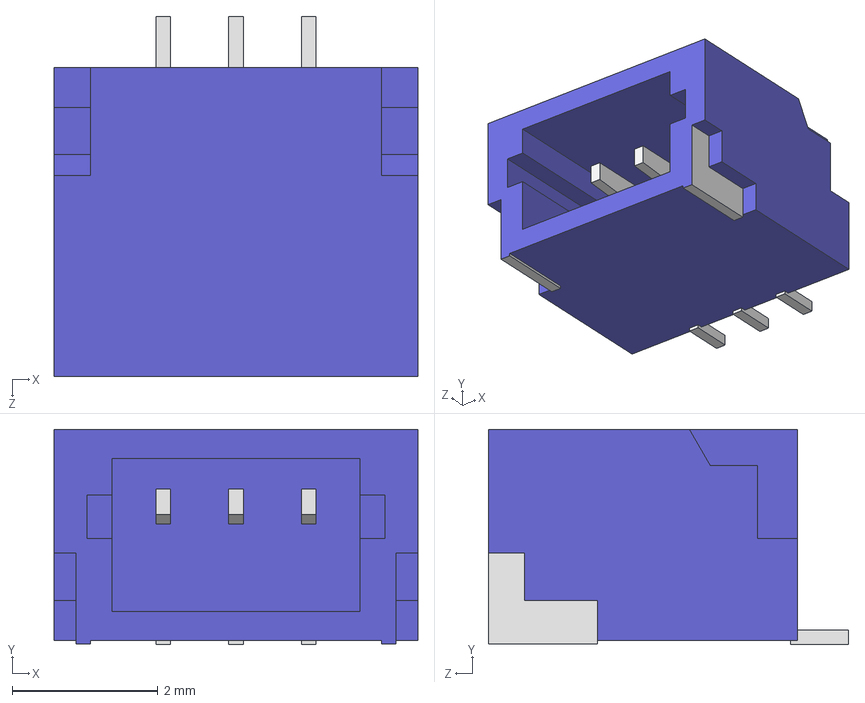
[picture p88: CAD file, 2024-04-19]
PCB/3d models/SMxxB-SRSS-TB/SM03B-SRSS-TB.STEP
5.00 x 2.96 x 4.95 mm
