bostang/PSoC6/PCB/3d models/SHR-xxV-S-B/SHR-05V-S-B.STEP

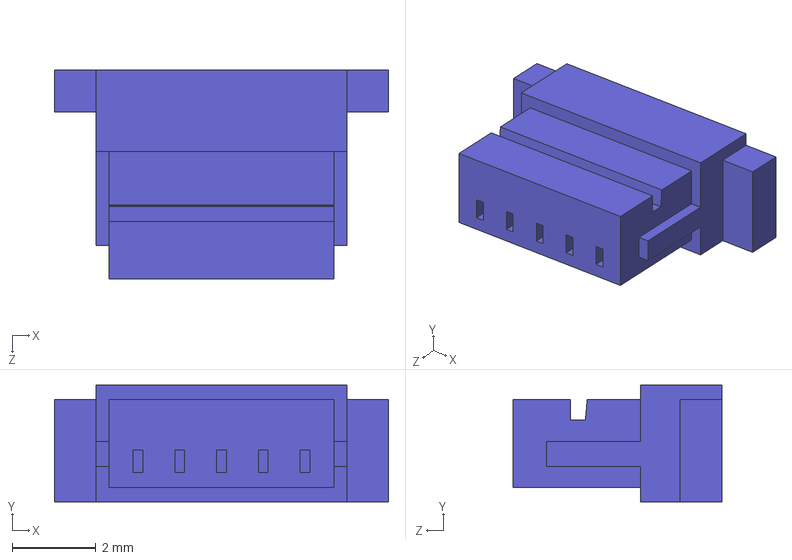
[picture p90: CAD file, 2024-04-19]
PCB/3d models/SHR-xxV-S-B/SHR-05V-S-B.STEP
8.00 x 2.80 x 5.00 mm
