bostang/PSoC6/PCB/3d models/BMxxB-SRSR-TB/BM13B-SRSS-TB.STEP

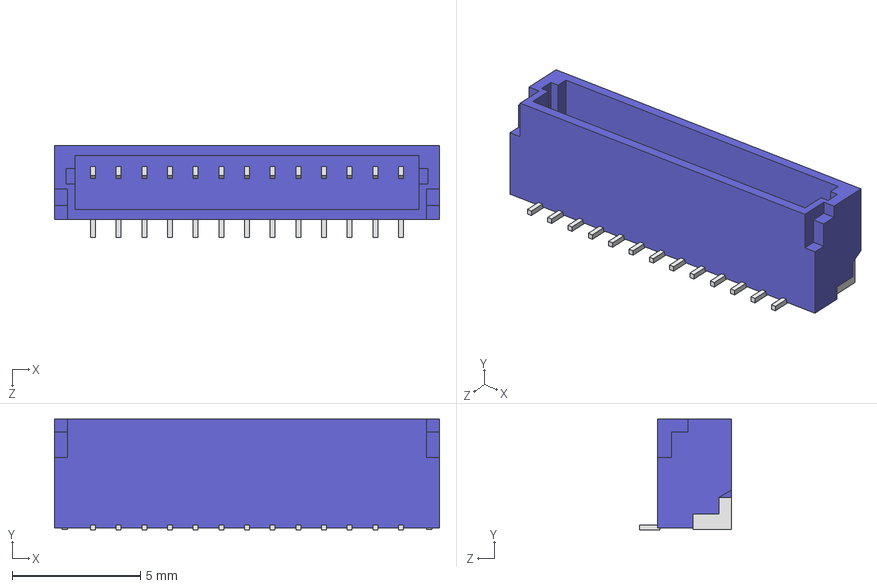
[picture p93: CAD file, 2024-04-19]
PCB/3d models/BMxxB-SRSR-TB/BM13B-SRSS-TB.STEP
15.0 x 4.32 x 3.60 mm
