bostang/PSoC6/PCB/3d models/SHR-xxV-S/SHR-10V-S.STEP

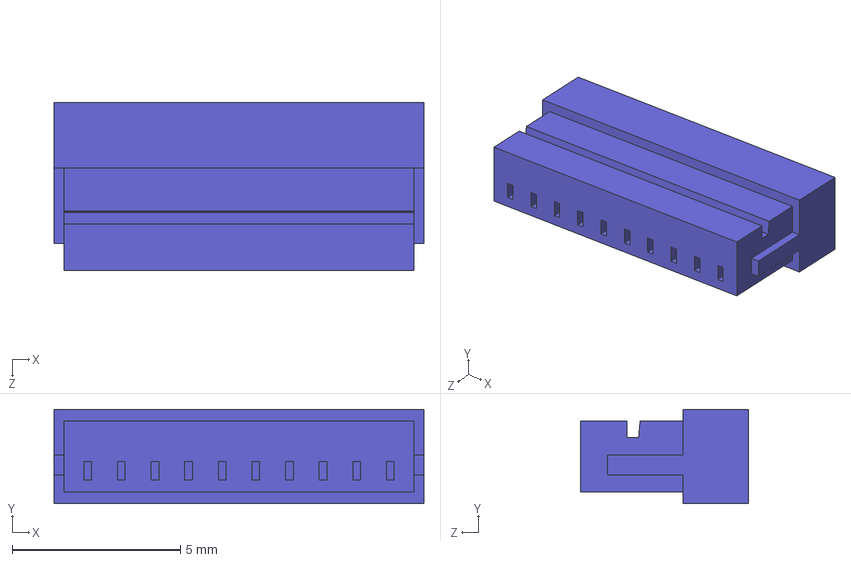
[picture p95: CAD file, 2024-04-19]
PCB/3d models/SHR-xxV-S/SHR-10V-S.STEP
11.0 x 2.80 x 5.00 mm
