bostang/PSoC6/PCB/3d models/SMxxB-SRSS-TB/SM15B-SRSS-TB.STEP

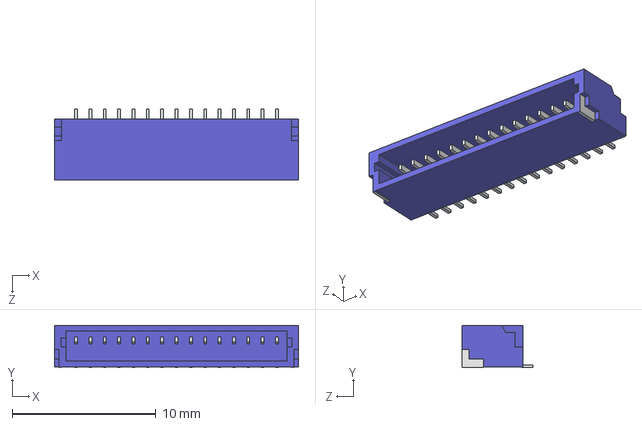
[picture p96: CAD file, 2024-04-19]
PCB/3d models/SMxxB-SRSS-TB/SM15B-SRSS-TB.STEP
17.0 x 2.96 x 4.95 mm
