bostang/PSoC6/PCB/3d models/BMxxB-SRSR-TB/BM03B-SRSS-TB.STEP

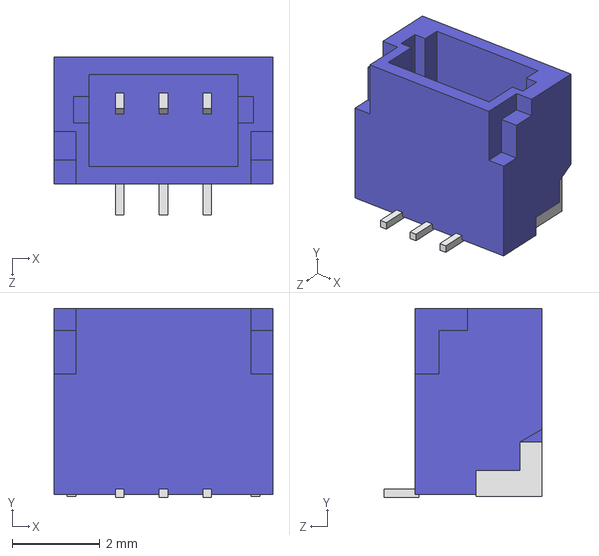
[picture p97: CAD file, 2024-04-19]
PCB/3d models/BMxxB-SRSR-TB/BM03B-SRSS-TB.STEP
5.00 x 4.32 x 3.60 mm
