bostang/PSoC6/PCB/3d models/SHR-xxV-S-B/SHR-09V-S-B.STEP

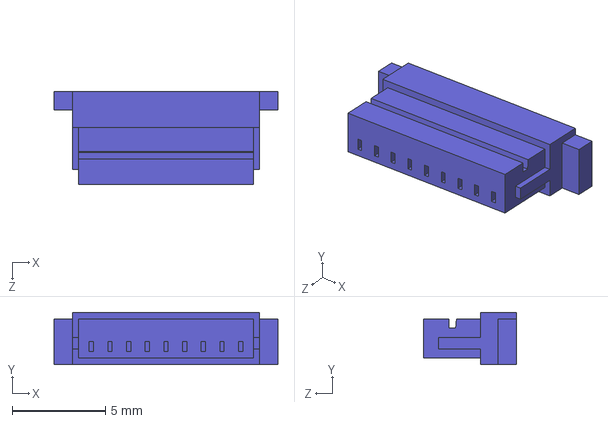
[picture p98: CAD file, 2024-04-19]
PCB/3d models/SHR-xxV-S-B/SHR-09V-S-B.STEP
12.0 x 2.80 x 5.00 mm
