bostang/PSoC6/PCB/3d models/SHR-xxV-S/SHR-04V-S.STEP

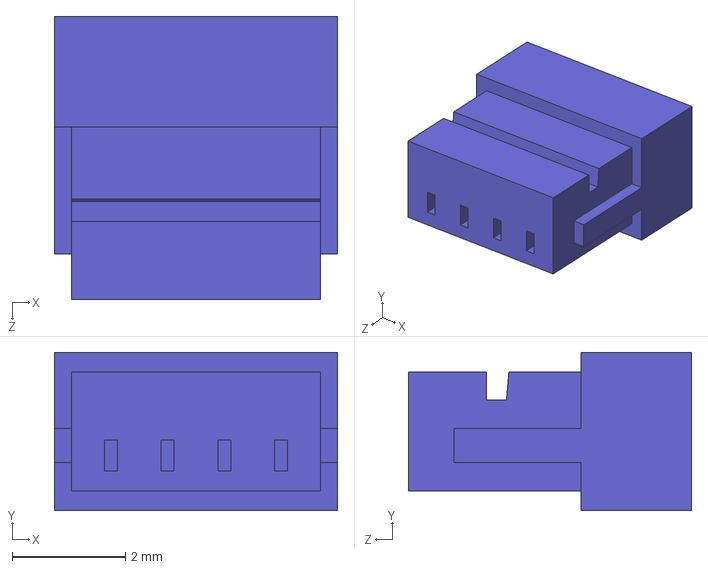
[picture p99: CAD file, 2024-04-19]
PCB/3d models/SHR-xxV-S/SHR-04V-S.STEP
5.00 x 2.80 x 5.00 mm
