bostang/PSoC6/PCB/3d models/SMxxB-SRSS-TB/SM05B-SRSS-TB.STEP

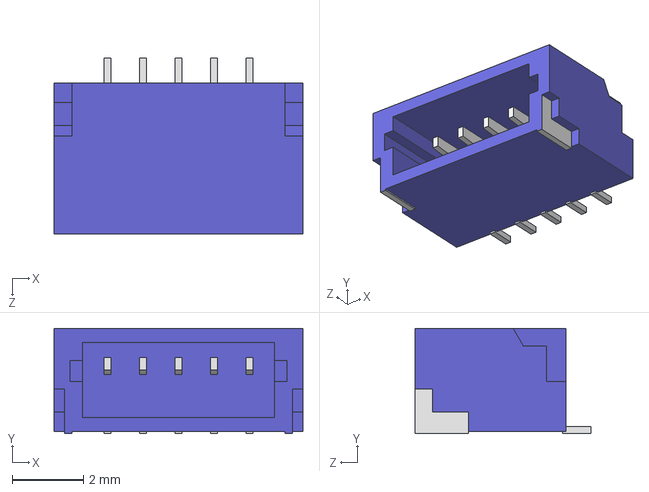
[picture p100: CAD file, 2024-04-19]
PCB/3d models/SMxxB-SRSS-TB/SM05B-SRSS-TB.STEP
7.00 x 2.96 x 4.95 mm
