bostang/PSoC6/PCB/3d models/SHR-xxV-S-B/SHR-11V-S-B.STEP

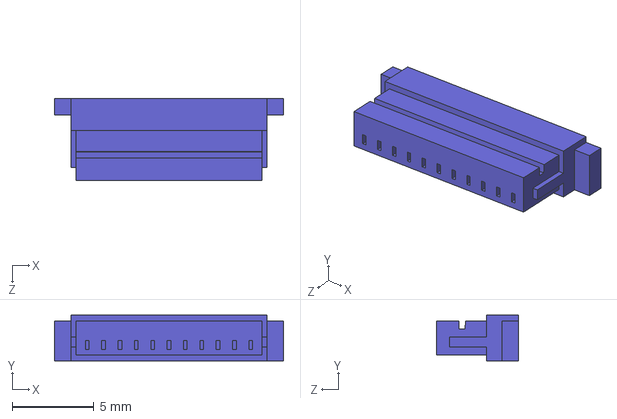
[picture p101: CAD file, 2024-04-19]
PCB/3d models/SHR-xxV-S-B/SHR-11V-S-B.STEP
14.0 x 2.80 x 5.00 mm
