bostang/PSoC6/(list of files, cad)

Other CAD files:
PCB/3d models/Mini Toggle Switches.step
PCB/3d models/MT3608 v2.3mf
PCB/3d models/12mm Push Button Cap.IGS
PCB/3d models/12mm Push Button Cap.SLDPRT
PCB/3d models/12mm Push Button with Cap.IGS
PCB/3d models/12mm Push Button with Cap.SLDASM
PCB/3d models/12mm Push Button.IGS
PCB/3d models/12mm Push Button.SLDPRT
PCB/3d models/FreeCAD Files/5mm DPDT Mini Toggle Switch.FCStd
PCB/3d models/FreeCAD Files/6mm DPDT Mini Toggle Switch.FCStd
PCB/3d models/FreeCAD Files/6mm SPDT Mini Toggle Switch.FCStd
PCB/3d models/JS102011SAQN.STEP
PCB/3d models/MT3608 v2.obj
PCB/3d models/MT3608 v3.stl
PCB/3d models/SSD1306_OLED_Display(128x64).f3d
