bostang/PSoC6/PCB/WMS/WMS_v3/WMS/WMS.pdf

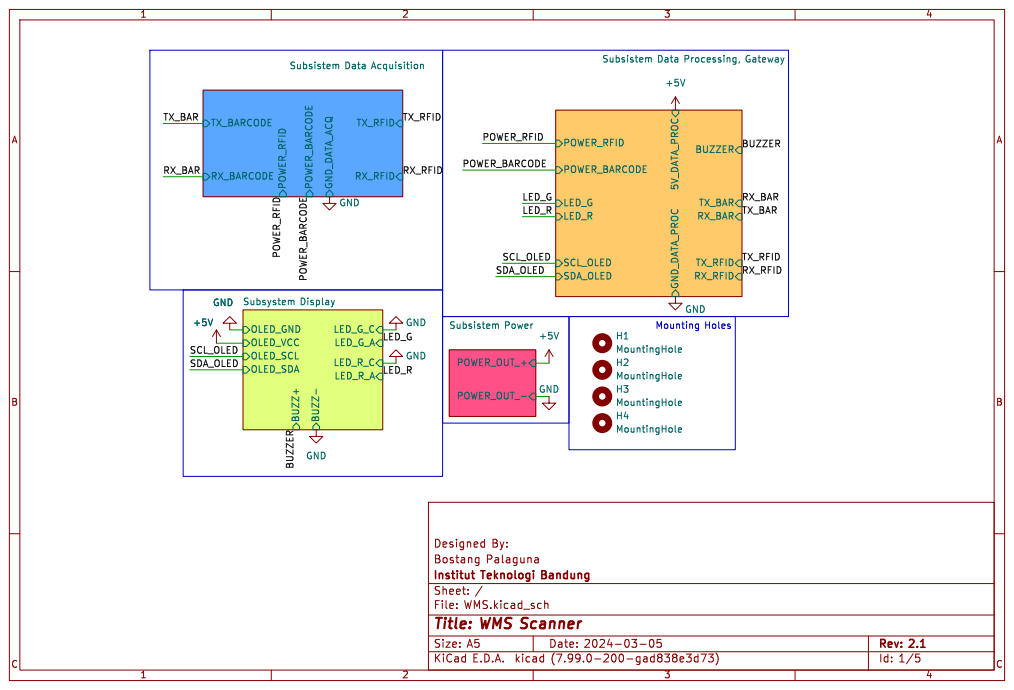
[picture p103: page 1]

Id: 1/5 Title: WMS Scanner File: WMS.kicad_sch Sheet: /

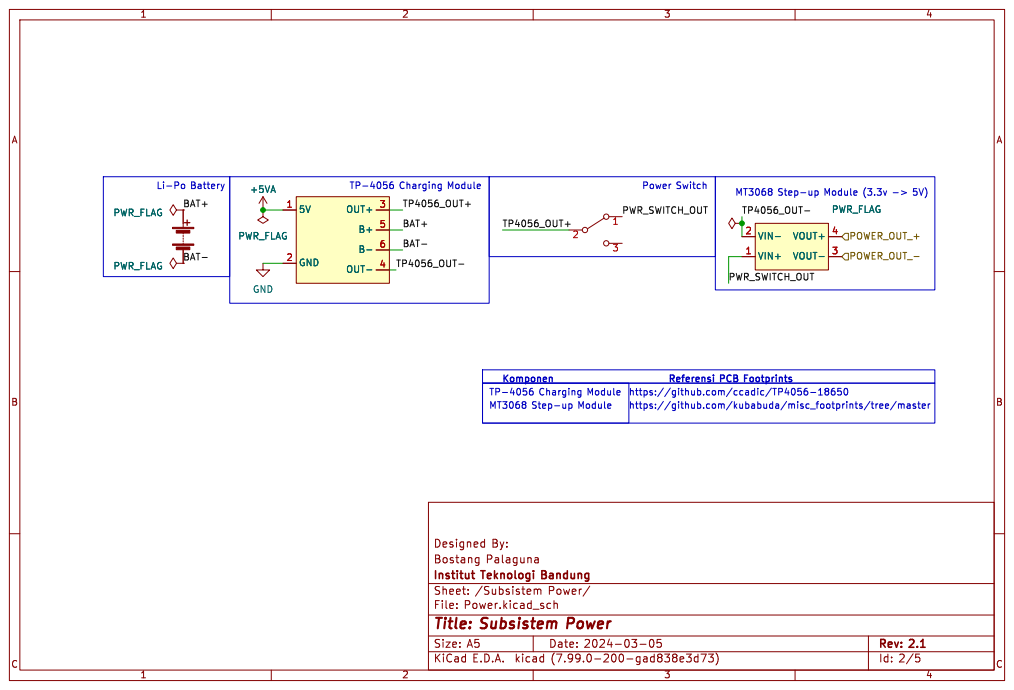
[picture p104: page 2]

https://github.com/ccadic/TP4056-18650

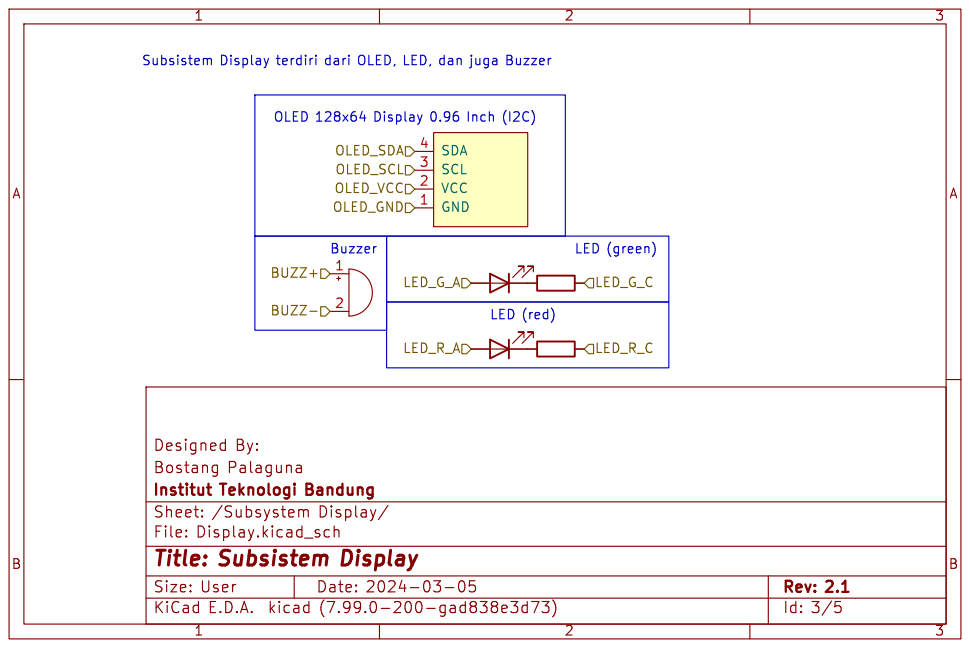
[picture p105: page 3]

Bostang Palaguna
Id: 3/5 Title: Subsistem Display

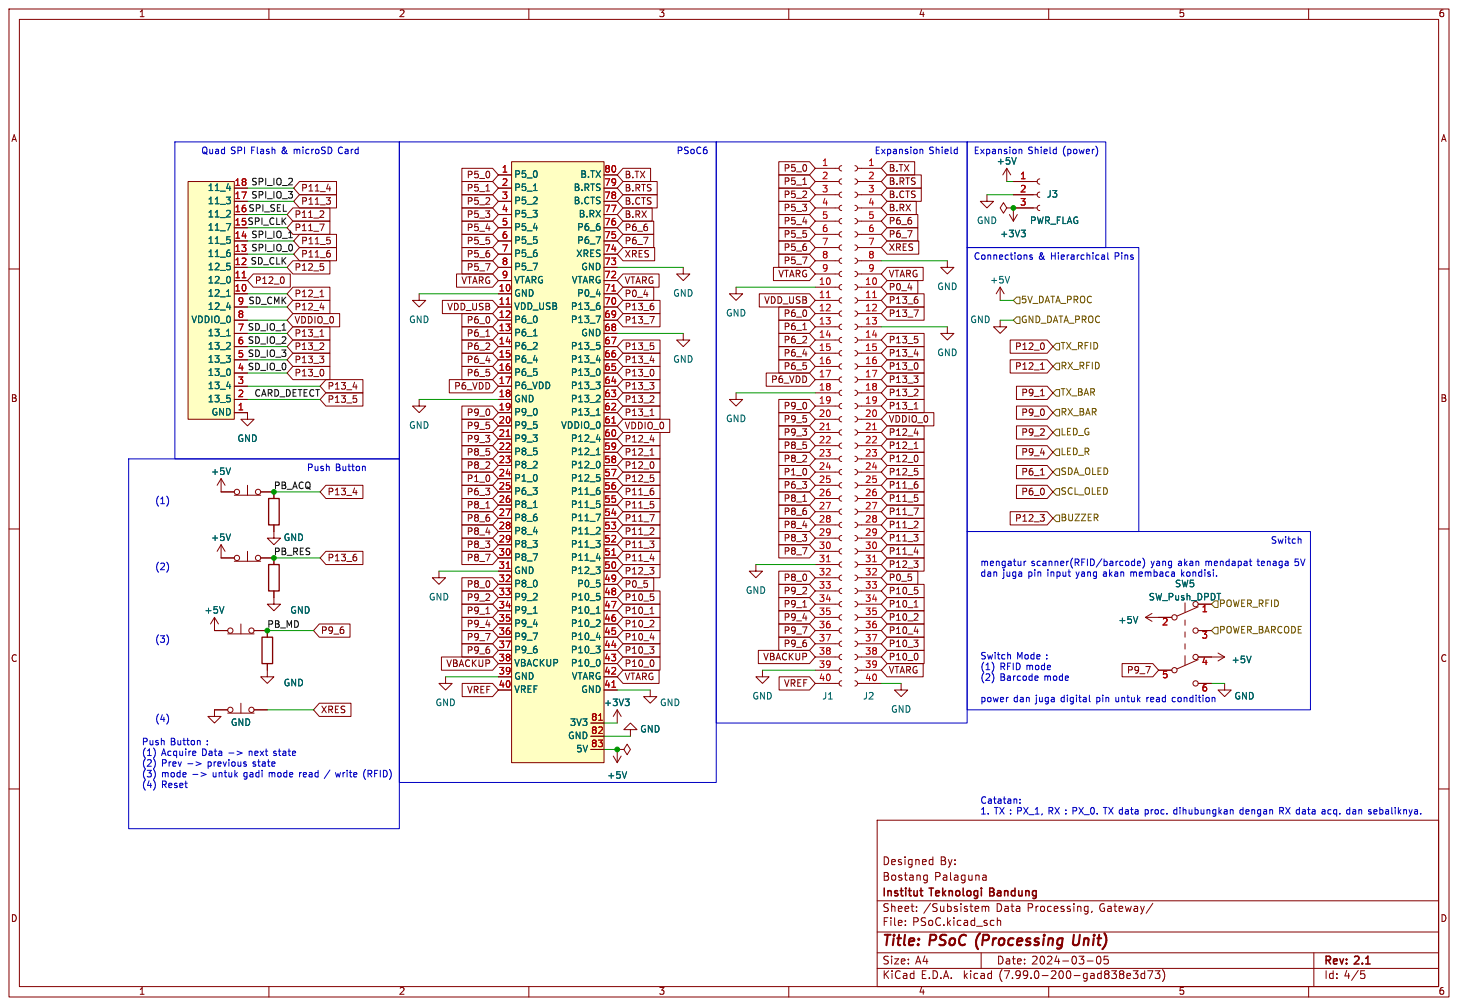
[picture p106: page 4]

(3) Push Button : (1) Acquire Data -> next state

power dan juga digital pin untuk read condition

(2) Prev -> previous state
(3) mode -> untuk gadi mode read / write (RFID)
(4) Reset

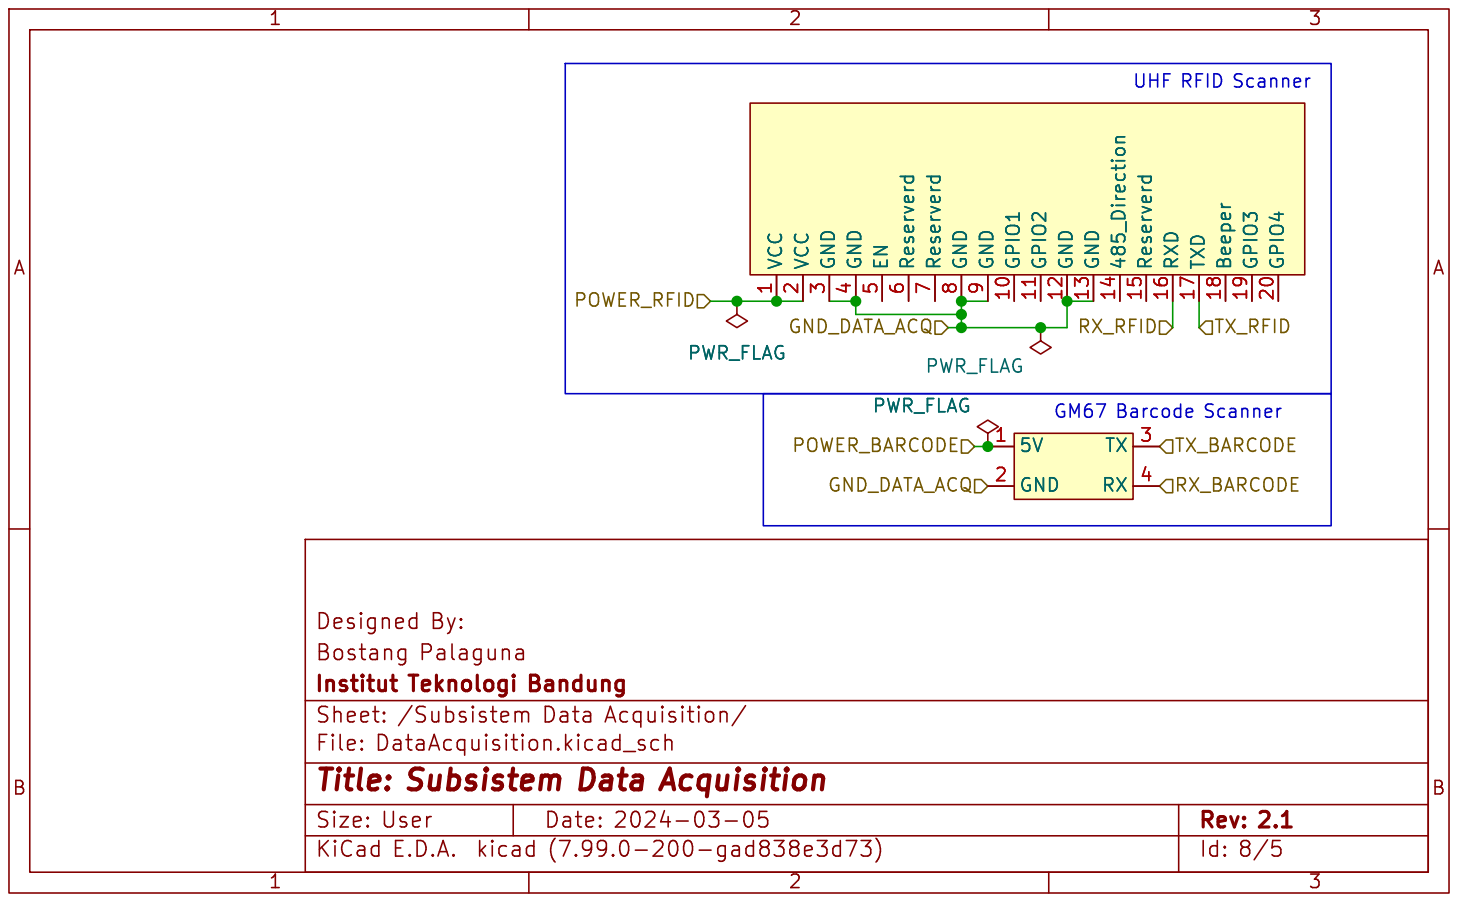
[picture p107: page 5]

1 GPIO1 10 GPIO2 11 GND 12 GND 13 485_Direction 14 Reserverd 15 RXD 16 TXD 17 Beeper 18 GPIO3 19 VCC

Id: 8/5 Title: Subsistem Data Acquisition
