bostang/PSoC6/PCB/WMS/WMS_v1 - layouted/WMS.pdf

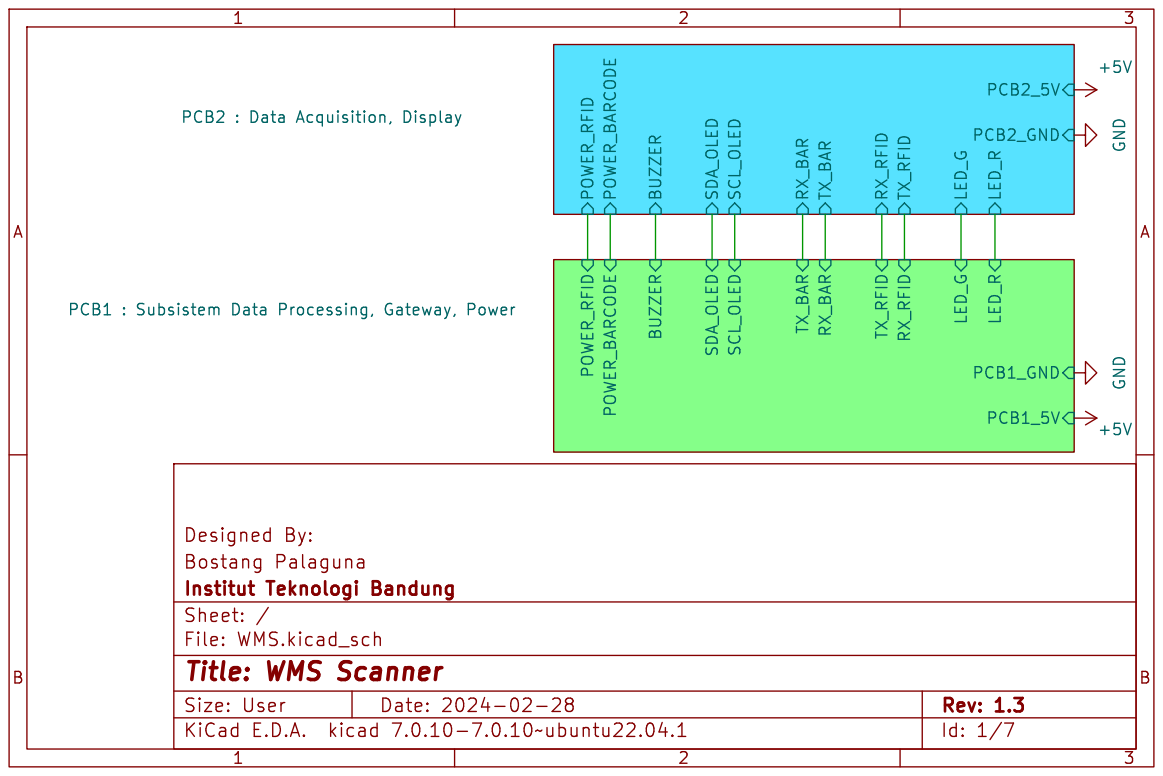
[picture p108: page 1]

Bostang Palaguna
Id: 1/7 Title: WMS Scanner File: WMS.kicad_sch Sheet: /

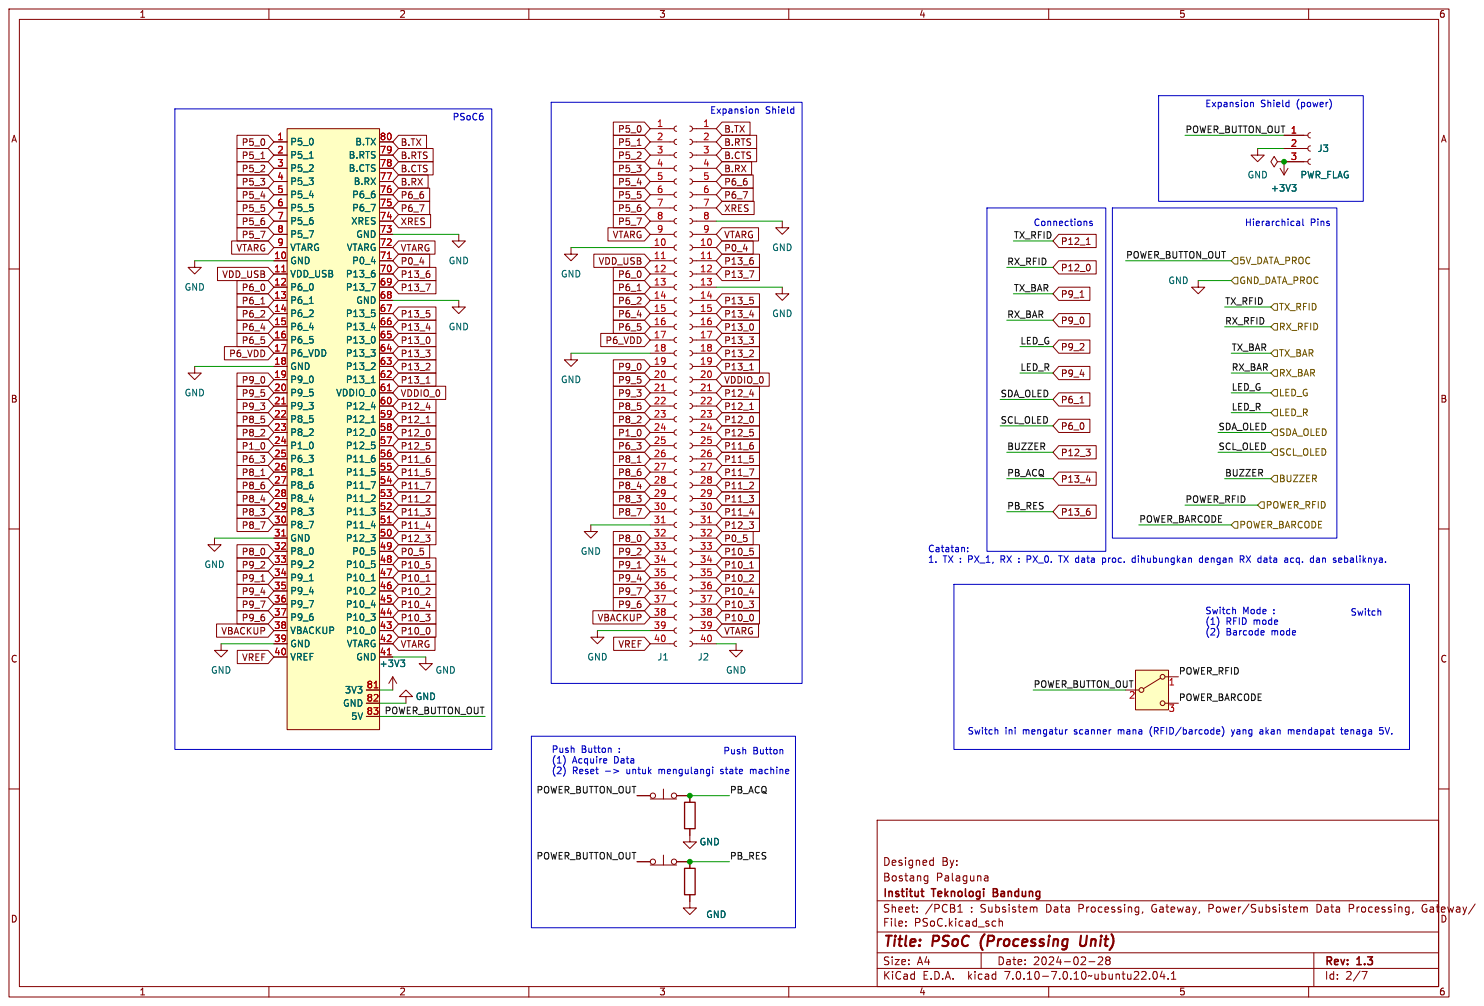
[picture p109: page 2]

Expansion Shield (power) Switch Mode : (1) RFID mode

Push Button : (1) Acquire Data

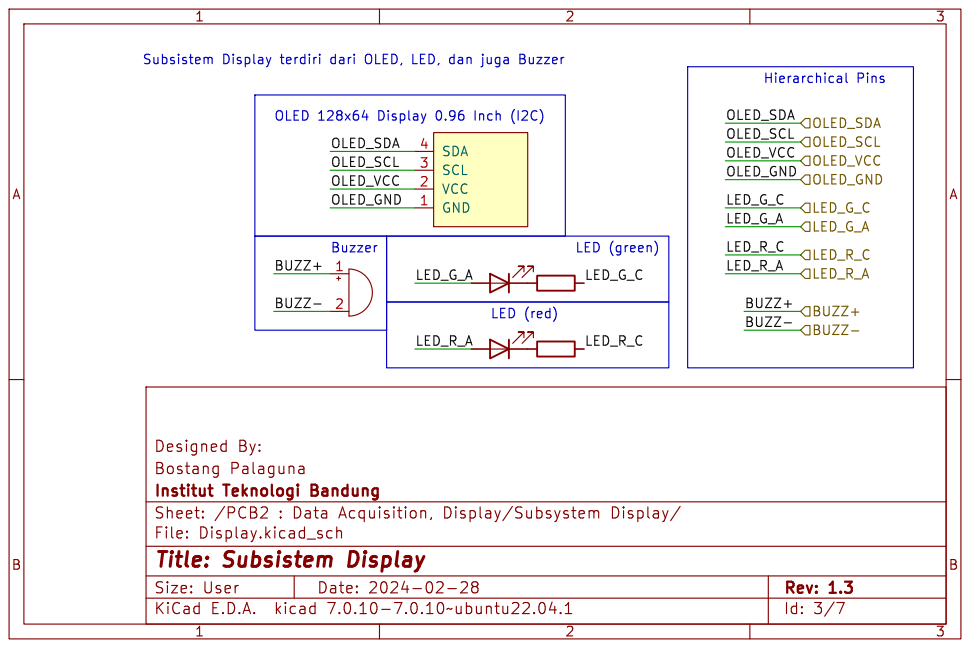
[picture p110: page 3]

Bostang Palaguna
Id: 3/7 Title: Subsistem Display

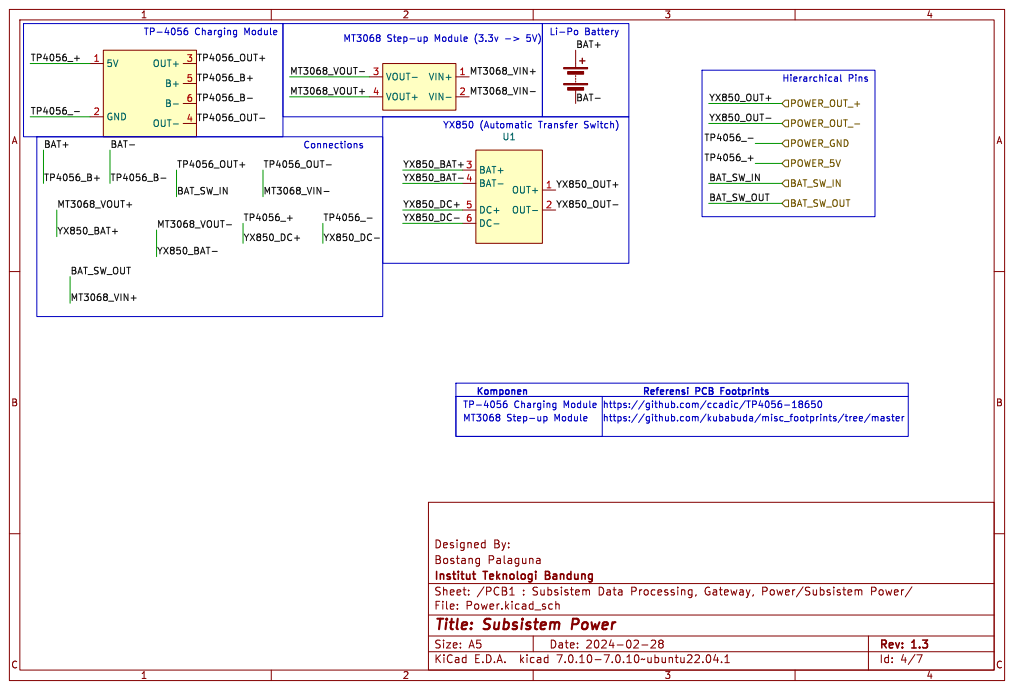
[picture p111: page 4]

https://github.com/ccadic/TP4056-18650
https://github.com/kubabuda/misc_footprints/tree/master

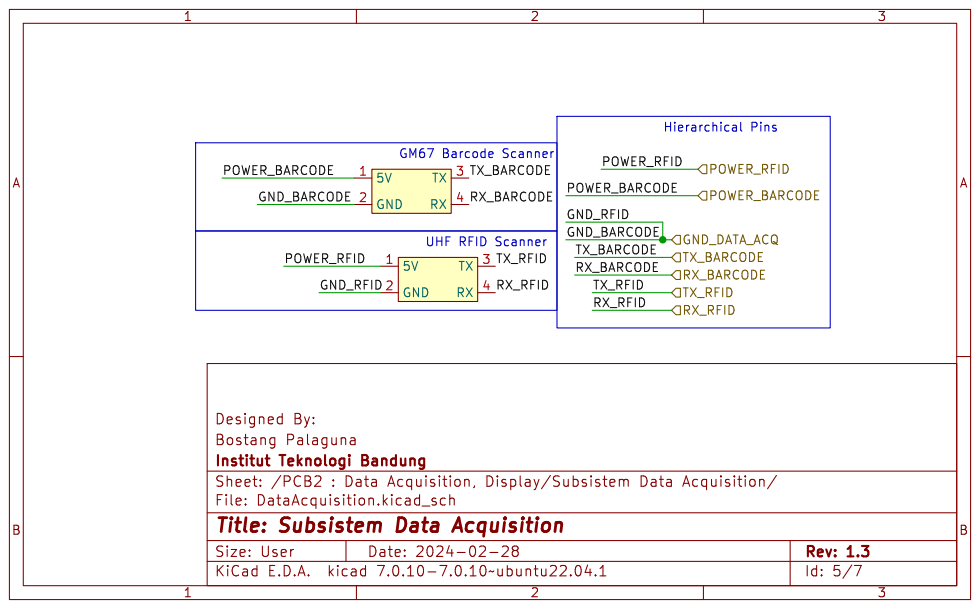
[picture p112: page 5]

Id: 5/7 Title: Subsistem Data Acquisition

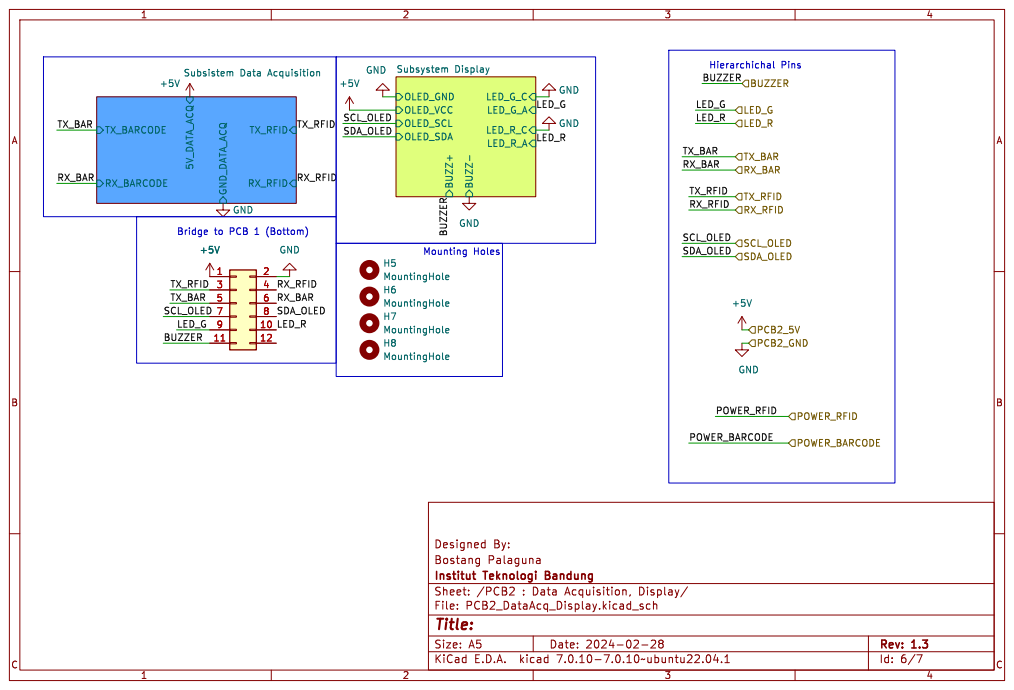
[picture p113: page 6]

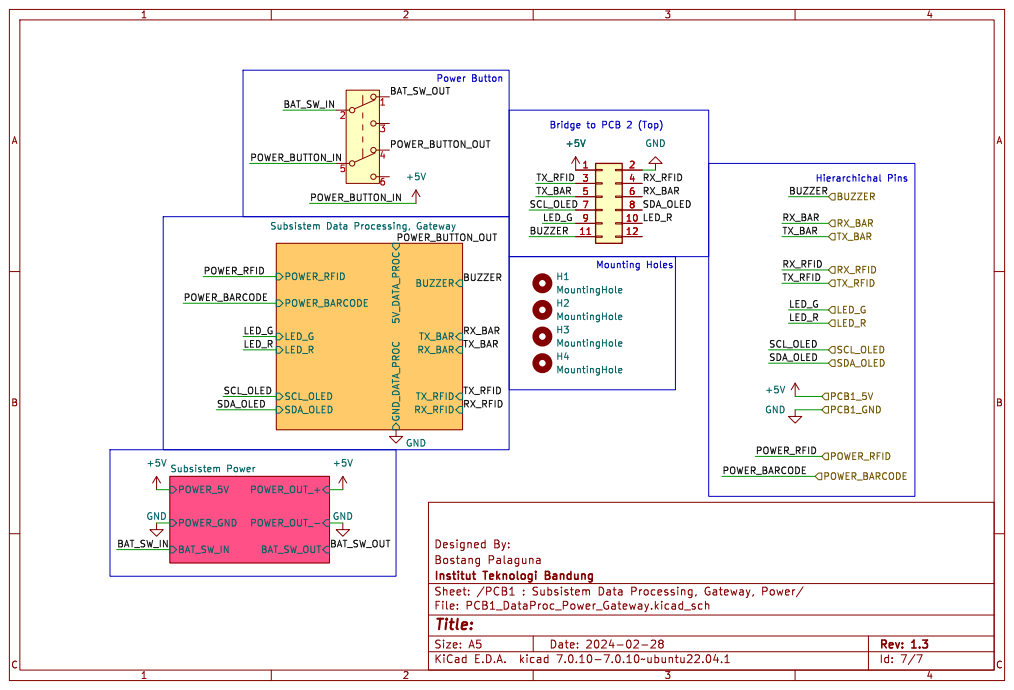
[picture p114: page 7]
