bostang/PSoC6/PCB/WMS/WMS_v3/WMS/WMS.kicad_pcb

## KiCad design PCB/WMS/WMS_v3/WMS/WMS.kicad_pcb (2024-04-19)

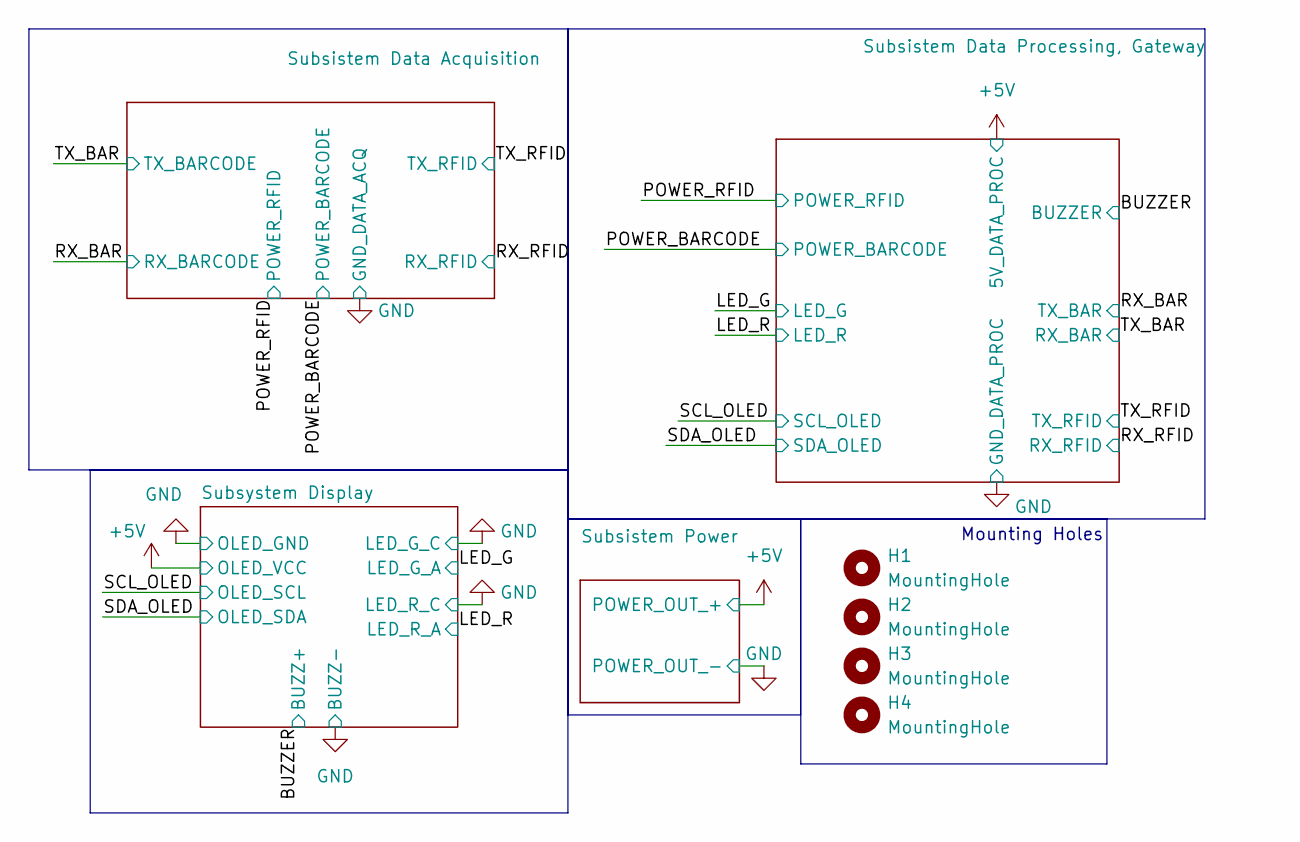
[picture p115: schematic WMS.kicad_sch, WMS Scanner]

Parts:
H1, H2, H3, H4: MountingHole; MountingHole_2.2mm_M2

Notes on the sheet:
Mounting Holes

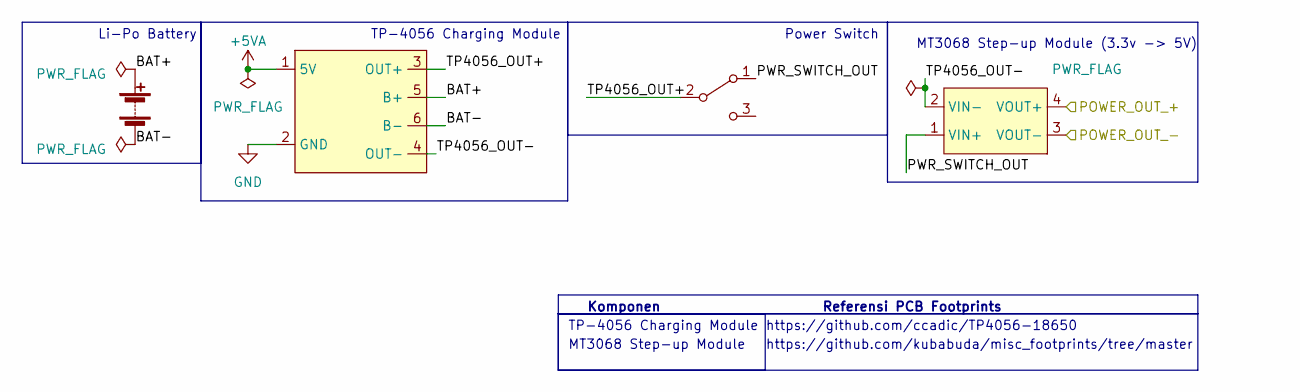
[picture p116: schematic Power.kicad_sch, Subsistem Power]

Parts:
BT1: Battery; BatteryHolder_Keystone_1042_1x18650
SW4: SW_SPDT; SPDT
U2: TP4056-18650_v2
U3: MT3608_module_v2

Connections:
+5V: U3.4 (VOUT+); also elsewhere on the board
+5VA: U2.1 (5V)
/Subsistem Power/BAT+: BT1.1 (+), U2.5 (B+)
/Subsistem Power/BAT-: BT1.2 (-), U2.6 (B-)
/Subsistem Power/PWR_SWITCH_OUT: SW4.1 (A), U3.1 (VIN+)
/Subsistem Power/TP4056_OUT+: SW4.2 (B), U2.3 (OUT+)
/Subsistem Power/TP4056_OUT-: U2.4 (OUT-), U3.2 (VIN-)
GND: U2.2 (GND), U3.3 (VOUT-); also elsewhere on the board

Notes on the sheet:
https://github.com/ccadic/TP4056-18650
https://github.com/kubabuda/misc_footprints/tree/master
TP-4056 Charging Module
Li-Po Battery
Komponen
MT3068 Step-up Module
Power Switch
Referensi PCB Footprints
MT3068 Step-up Module (3.3v -> 5V)

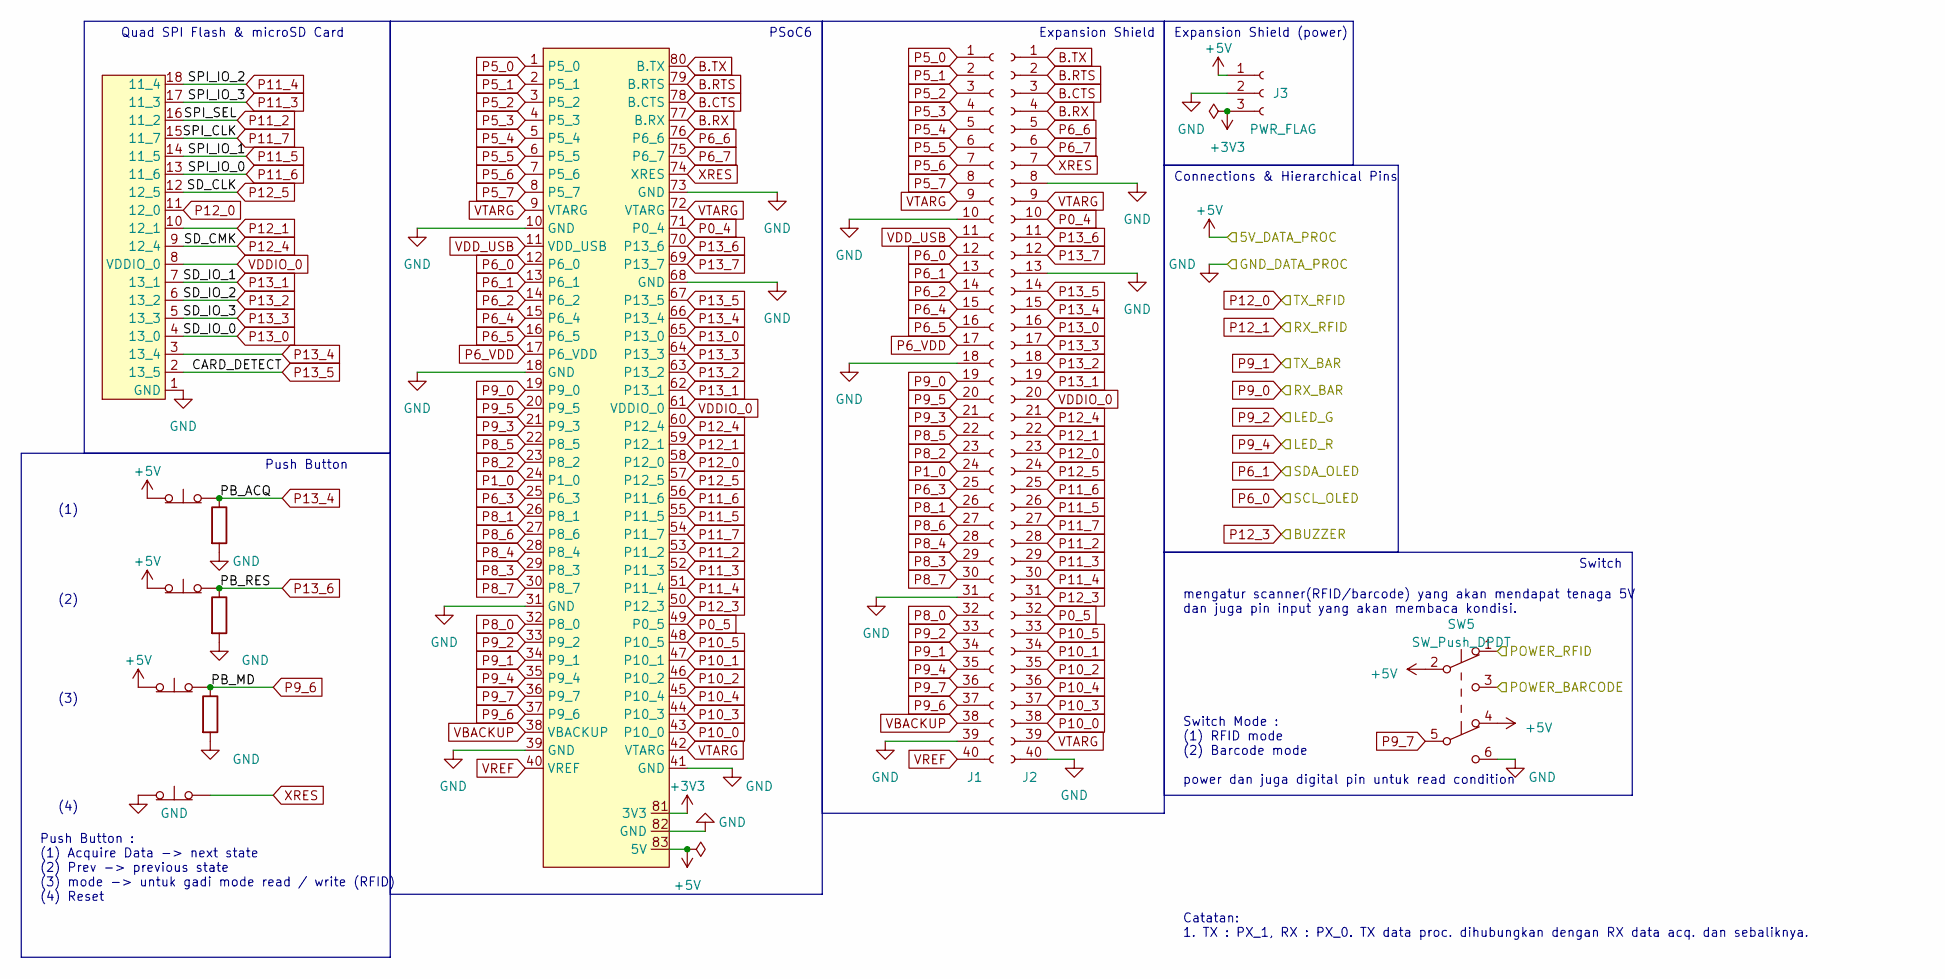
[picture p117: schematic PSoC.kicad_sch, PSoC (Processing Unit)]

Parts:
J1, J2: Conn_01x40_Socket; PinHeader_1x40_P2.54mm_Vertical
J3: Conn_01x03_Socket; PinHeader_1x03_P2.54mm_Vertical
R3, R4, R5: 10k; R_0805_2012Metric
SW1, SW2, SW3: SW_Push_Open; SW_PUSH-12mm
SW5: SW_Push_DPDT; DPDT
SW6: SW_Push_Open; SW_PUSH_6mm_H9.5mm
U5: Quad_SPI_flash_microSD_v2
U6: CY8CPROTO-062-4343W_v3

Connections:
+3V3: J3.3, U6.81 (3V3)
+5V: J3.1, SW1.1 (A), SW2.1 (A), SW3.1 (A), SW5.2 (B), SW5.4 (A), U6.83 (5V); also elsewhere on the board
/POWER_BARCODE: SW5.3 (C); also elsewhere on the board
/POWER_RFID: SW5.1 (A); also elsewhere on the board
B.CTS: J2.3, U6.78 (B.CTS)
B.RTS: J2.2, U6.79 (B.RTS)
B.RX: J2.4, U6.77 (B.RX)
B.TX: J2.1, U6.80 (B.TX)
GND: J1.10, J1.18, J1.31, J1.39, J2.8, J2.13, J2.40, J3.2, R3.2, R4.2, R5.2, SW5.6 (C), SW6.1 (A), U5.1 (GND), U6.10 (GND), U6.18 (GND), U6.31 (GND), U6.39 (GND), U6.41 (GND), U6.68 (GND), U6.73 (GND), U6.82 (GND); also elsewhere on the board
P0_4: J2.10, U6.71 (P0_4)
P0_5: J2.32, U6.49 (P0_5)
P1_0: J1.24, U6.24 (P1_0)
P5_0: J1.1, U6.1 (P5_0)
P5_1: J1.2, U6.2 (P5_1)
P5_2: J1.3, U6.3 (P5_2)
P5_3: J1.4, U6.4 (P5_3)
P5_4: J1.5, U6.5 (P5_4)
P5_5: J1.6, U6.6 (P5_5)
P5_6: J1.7, U6.7 (P5_6)
P5_7: J1.8, U6.8 (P5_7)
P6_0: J1.12, U6.12 (P6_0); also elsewhere on the board
P6_1: J1.13, U6.13 (P6_1); also elsewhere on the board
P6_2: J1.14, U6.14 (P6_2)
P6_3: J1.25, U6.25 (P6_3)
P6_4: J1.15, U6.15 (P6_4)
P6_5: J1.16, U6.16 (P6_5)
P6_6: J2.5, U6.76 (P6_6)
P6_7: J2.6, U6.75 (P6_7)
P6_VDD: J1.17, U6.17 (P6_VDD)
P8_0: J1.32, U6.32 (P8_0)
P8_1: J1.26, U6.26 (P8_1)
P8_2: J1.23, U6.23 (P8_2)
P8_3: J1.29, U6.29 (P8_3)
P8_4: J1.28, U6.28 (P8_4)
P8_5: J1.22, U6.22 (P8_5)
P8_6: J1.27, U6.27 (P8_6)
P8_7: J1.30, U6.30 (P8_7)
P9_0: J1.19, U6.19 (P9_0); also elsewhere on the board
P9_1: J1.34, U6.34 (P9_1); also elsewhere on the board
P9_2: J1.33, U6.33 (P9_2); also elsewhere on the board
P9_3: J1.21, U6.21 (P9_3)
P9_4: J1.35, U6.35 (P9_4); also elsewhere on the board
P9_5: J1.20, U6.20 (P9_5)
P9_6: J1.37, R5.1, SW3.2 (B), U6.37 (P9_6)
P9_7: J1.36, SW5.5 (B), U6.36 (P9_7)
P10_0: J2.38, U6.43 (P10_0)
P10_1: J2.34, U6.47 (P10_1)
P10_2: J2.35, U6.46 (P10_2)
P10_3: J2.37, U6.44 (P10_3)
P10_4: J2.36, U6.45 (P10_4)
P10_5: J2.33, U6.48 (P10_5)
P11_2: J2.28, U5.16 (11_2), U6.53 (P11_2)
P11_3: J2.29, U5.17 (11_3), U6.52 (P11_3)
P11_4: J2.30, U5.18 (11_4), U6.51 (P11_4)
P11_5: J2.26, U5.14 (11_5), U6.55 (P11_5)
P11_6: J2.25, U5.13 (11_6), U6.56 (P11_6)
P11_7: J2.27, U5.15 (11_7), U6.54 (P11_7)
P12_0: J2.23, U5.11 (12_0), U6.58 (P12_0); also elsewhere on the board
P12_1: J2.22, U5.10 (12_1), U6.59 (P12_1); also elsewhere on the board
P12_3: J2.31, U6.50 (P12_3); also elsewhere on the board
P12_4: J2.21, U5.9 (12_4), U6.60 (P12_4)
P12_5: J2.24, U5.12 (12_5), U6.57 (P12_5)
P13_0: J2.16, U5.4 (13_0), U6.65 (P13_0)
P13_1: J2.19, U5.7 (13_1), U6.62 (P13_1)
P13_2: J2.18, U5.6 (13_2), U6.63 (P13_2)
P13_3: J2.17, U5.5 (13_3), U6.64 (P13_3)
P13_4: J2.15, R3.1, SW1.2 (B), U5.3 (13_4), U6.66 (P13_4)
P13_5: J2.14, U5.2 (13_5), U6.67 (P13_5)
P13_6: J2.11, R4.1, SW2.2 (B), U6.70 (P13_6)
P13_7: J2.12, U6.69 (P13_7)
VBACKUP: J1.38, U6.38 (VBACKUP)
VDDIO_0: J2.20, U5.8 (VDDIO_0), U6.61 (VDDIO_0)
VDD_USB: J1.11, U6.11 (VDD_USB)
VREF: J1.40, U6.40 (VREF)
VTARG: J1.9, J2.9, J2.39, U6.9 (VTARG), U6.42 (VTARG), U6.72 (VTARG)
XRES: J2.7, SW6.2 (B), U6.74 (XRES)

Notes on the sheet:
(3)
PSoC6
Expansion Shield (power)
(2)
(4)
Push Button : (1) Acquire Data -> next state (2) Prev -> previous state (3) mode -> untuk gadi mode read / write (RFID) (4) Reset
(1)
Switch
Expansion Shield
Connections & Hierarchical Pins
mengatur scanner(RFID/barcode) yang akan mendapat tenaga 5V dan juga pin input yang akan membaca kondisi.
Catatan: 1. TX : PX_1, RX : PX_0. TX data proc. dihubungkan dengan RX data acq. dan sebaliknya.
Switch Mode : (1) RFID mode (2) Barcode mode power dan juga digital pin untuk read condition
Quad SPI Flash & microSD Card
Push Button

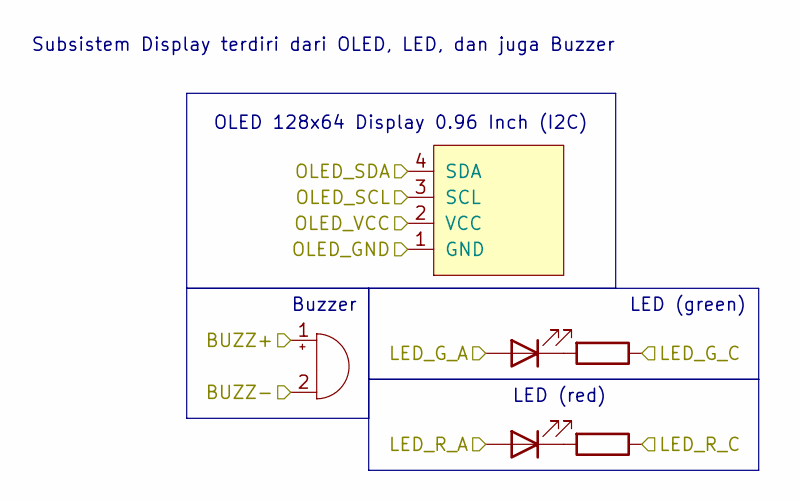
[picture p118: schematic Display.kicad_sch, Subsistem Display]

Parts:
BZ1: Buzzer; Buzzer_12x9.5RM7.6
Brd1: SSD1306; 128x64OLED
D1, D2: LED; LED_D3.0mm
R1: 82; R_0805_2012Metric
R2: 120; R_0805_2012Metric

Connections:
+5V: Brd1.2 (VCC); also elsewhere on the board
GND: BZ1.2 (+), Brd1.1 (GND), R1.1, R2.1; also elsewhere on the board
unnamed: D1.1 (K), R1.2
unnamed: D2.1 (K), R2.2
P6_0: Brd1.3 (SCL); also elsewhere on the board
P6_1: Brd1.4 (SDA); also elsewhere on the board
P9_2: D1.2 (A); also elsewhere on the board
P9_4: D2.2 (A); also elsewhere on the board
P12_3: BZ1.1 (-); also elsewhere on the board

Notes on the sheet:
Subsistem Display terdiri dari OLED, LED, dan juga Buzzer
LED (red)
Buzzer
OLED 128x64 Display 0.96 Inch (I2C)
LED (green)

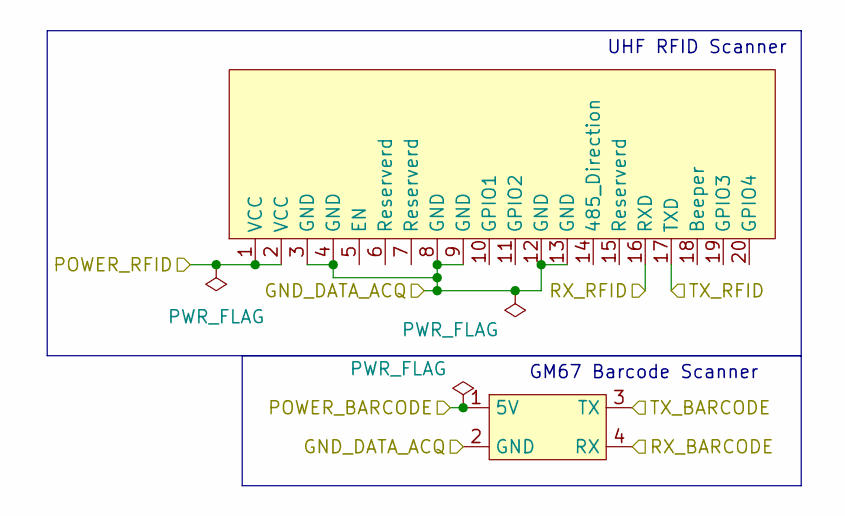
[picture p119: schematic DataAcquisition.kicad_sch, Subsistem Data Acquisition]

Parts:
U1: YR903_RFID_Scanner_FPC_v2
U4: JST_SH_SM04B-SRSS-TB_1x04-1MP_P1.00mm_Horizontal

Connections:
/POWER_BARCODE: U4.1 (5V); also elsewhere on the board
/POWER_RFID: U1.1 (VCC), U1.2 (VCC); also elsewhere on the board
GND: U1.3 (GND), U1.4 (GND), U1.8 (GND), U1.9 (GND), U1.12 (GND), U1.13 (GND), U4.2 (GND); also elsewhere on the board
P9_0: U4.3 (TX); also elsewhere on the board
P9_1: U4.4 (RX); also elsewhere on the board
P12_0: U1.17 (TXD); also elsewhere on the board
P12_1: U1.16 (RXD); also elsewhere on the board

Notes on the sheet:
UHF RFID Scanner
GM67 Barcode Scanner

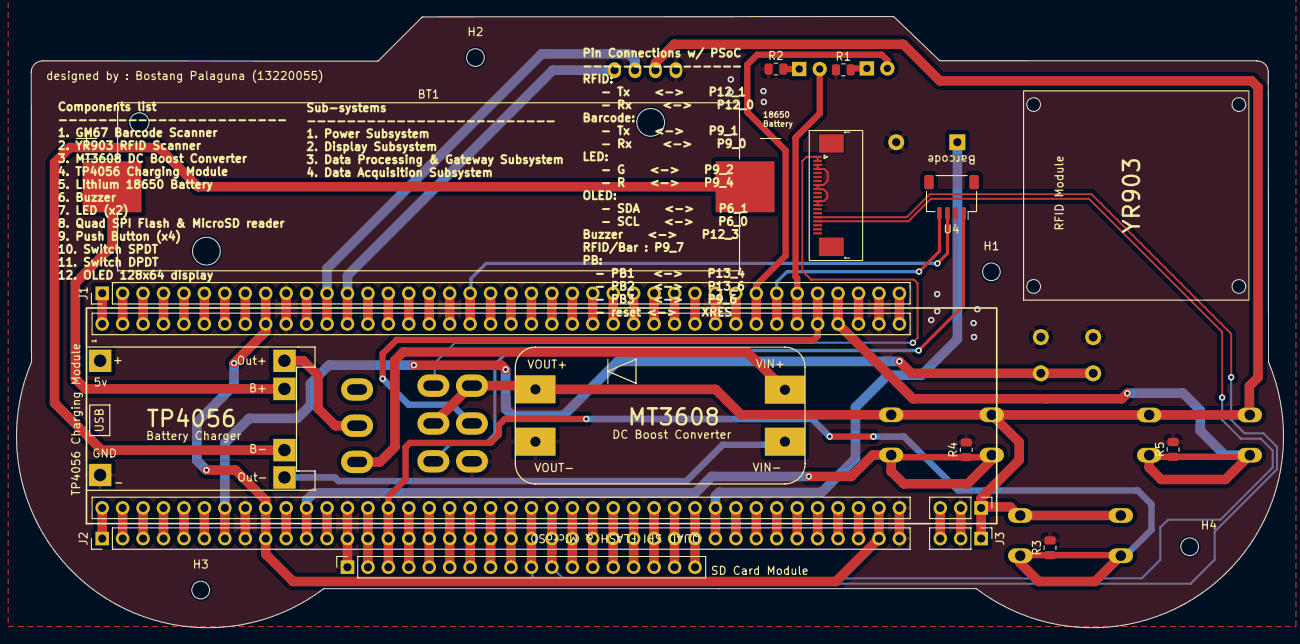
[picture p120: board WMS.kicad_pcb from above]

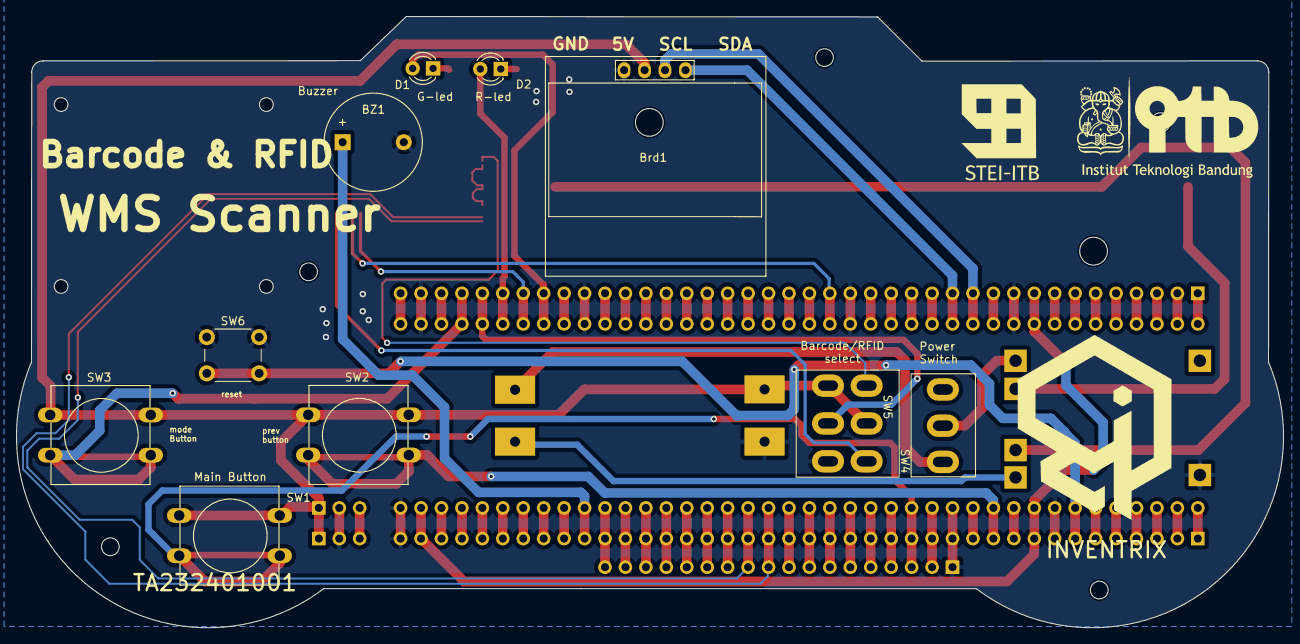
[picture p121: board WMS.kicad_pcb from below]

Board: 2 copper layers, 157.4 x 75.9 mm, 29 parts (10 on the bottom side), 83 nets.
