bostang/PSoC6/PCB/WMS_Scanner/WMS_Scanner.kicad_pcb

## KiCad design PCB/WMS_Scanner/WMS_Scanner.kicad_pcb (2024-03-05)

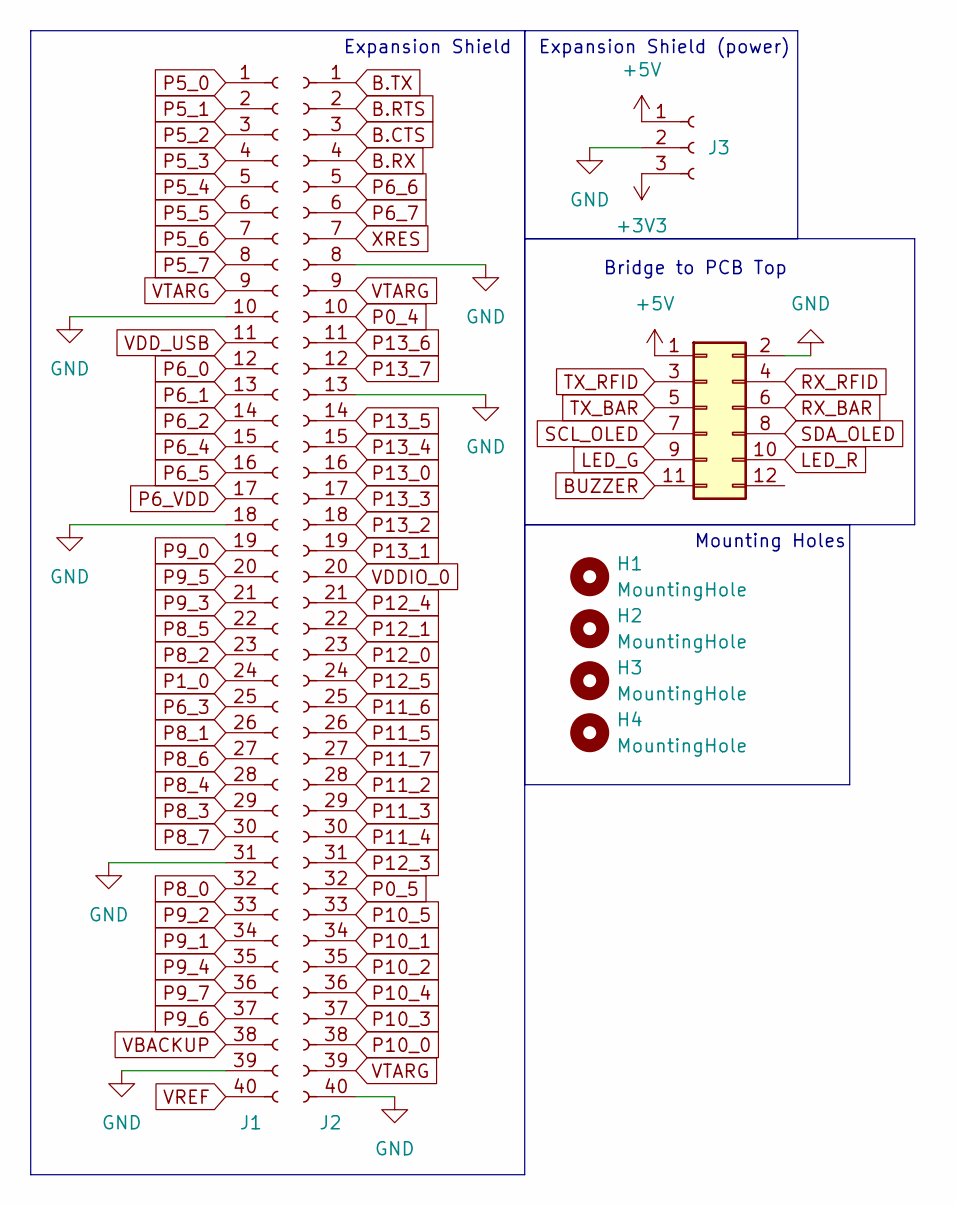
[picture p122: schematic WMS_Scanner.kicad_sch, WMS Scanner]

Parts:
H1, H2, H3, H4: MountingHole; MountingHole_2.2mm_M2
J1, J2: Conn_01x40_Socket; PinHeader_1x40_P2.54mm_Vertical
J3: Conn_01x03_Socket; PinHeader_1x03_P2.54mm_Vertical
J4: Conn_02x06_Odd_Even; JST_PHD_B12B-PHDSS_2x06_P2.00mm_Vertical

Connections:
+3V3: J3.3
+5V: J3.1, J4.1
B.CTS: J2.3
B.RTS: J2.2
B.RX: J2.4
B.TX: J2.1
BUZZER: J4.11
GND: J1.10, J1.18, J1.31, J1.39, J2.8, J2.13, J2.40, J3.2, J4.2
LED_G: J4.9
LED_R: J4.10
P0_4: J2.10
P0_5: J2.32
P1_0: J1.24
P5_0: J1.1
P5_1: J1.2
P5_2: J1.3
P5_3: J1.4
P5_4: J1.5
P5_5: J1.6
P5_6: J1.7
P5_7: J1.8
P6_0: J1.12
P6_1: J1.13
P6_2: J1.14
P6_3: J1.25
P6_4: J1.15
P6_5: J1.16
P6_6: J2.5
P6_7: J2.6
P6_VDD: J1.17
P8_0: J1.32
P8_1: J1.26
P8_2: J1.23
P8_3: J1.29
P8_4: J1.28
P8_5: J1.22
P8_6: J1.27
P8_7: J1.30
P9_0: J1.19
P9_1: J1.34
P9_2: J1.33
P9_3: J1.21
P9_4: J1.35
P9_5: J1.20
P9_6: J1.37
P9_7: J1.36
P10_0: J2.38
P10_1: J2.34
P10_2: J2.35
P10_3: J2.37
P10_4: J2.36
P10_5: J2.33
P11_2: J2.28
P11_3: J2.29
P11_4: J2.30
P11_5: J2.26
P11_6: J2.25
P11_7: J2.27
P12_0: J2.23
P12_1: J2.22
P12_3: J2.31
P12_4: J2.21
P12_5: J2.24
P13_0: J2.16
P13_1: J2.19
P13_2: J2.18
P13_3: J2.17
P13_4: J2.15
P13_5: J2.14
P13_6: J2.11
P13_7: J2.12
RX_BAR: J4.6
RX_RFID: J4.4
SCL_OLED: J4.7
SDA_OLED: J4.8
TX_BAR: J4.5
TX_RFID: J4.3
VBACKUP: J1.38
VDDIO_0: J2.20
VDD_USB: J1.11
VREF: J1.40
VTARG: J1.9, J2.9, J2.39
XRES: J2.7

Notes on the sheet:
Bridge to PCB Top
Expansion Shield
Mounting Holes
Expansion Shield (power)

Board: 2 copper layers, 8 parts (0 on the bottom side), 3 nets, no tracks yet.
