bostang/PSoC6/PCB/WMS/WMS_v3/WMS/WMS_PCB2.kicad_pcb

## KiCad design PCB/WMS/WMS_v3/WMS/WMS_PCB2.kicad_pcb (2024-03-06)

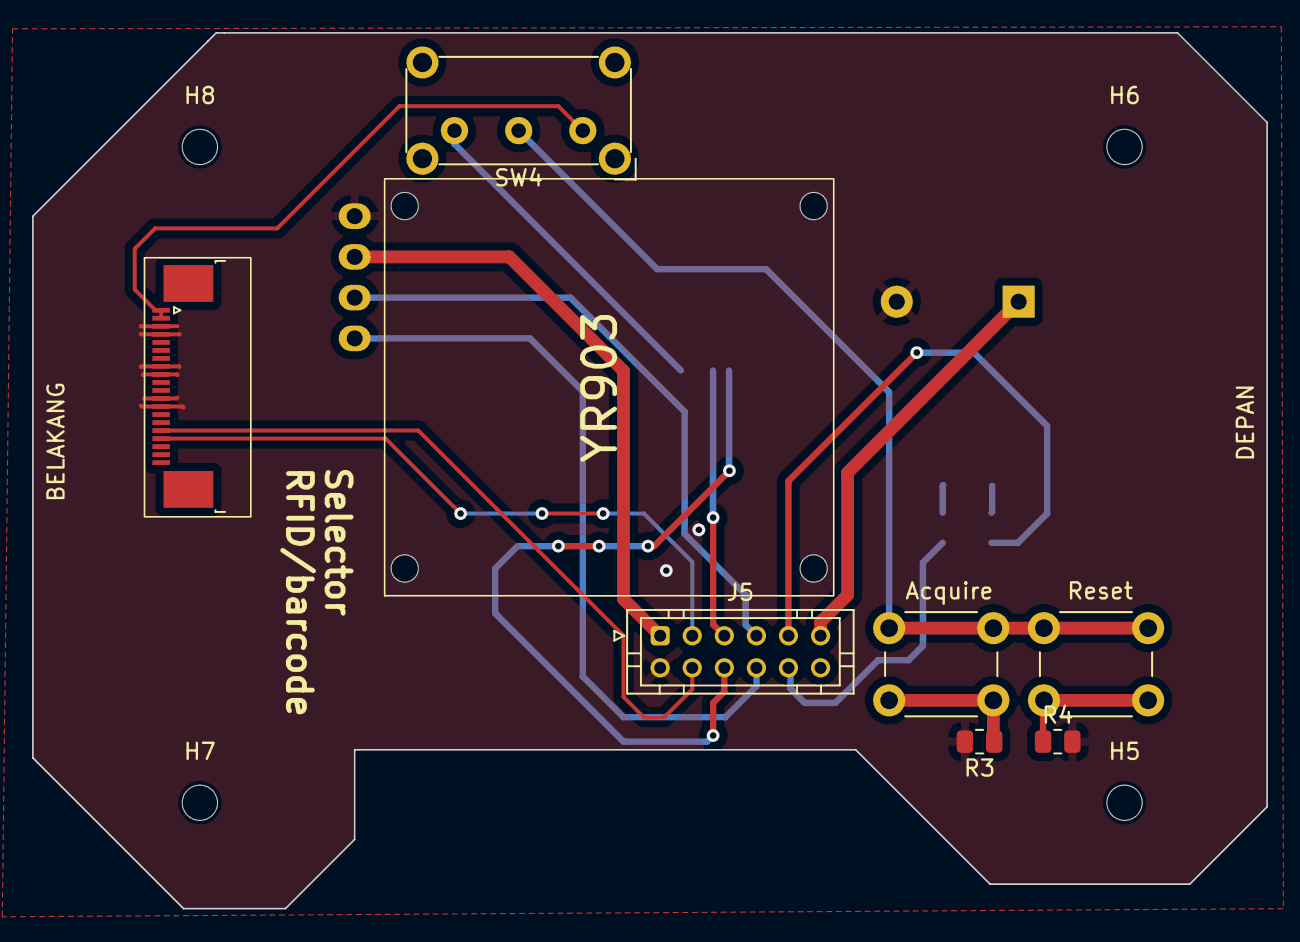
[picture p123: board WMS_PCB2.kicad_pcb from above]

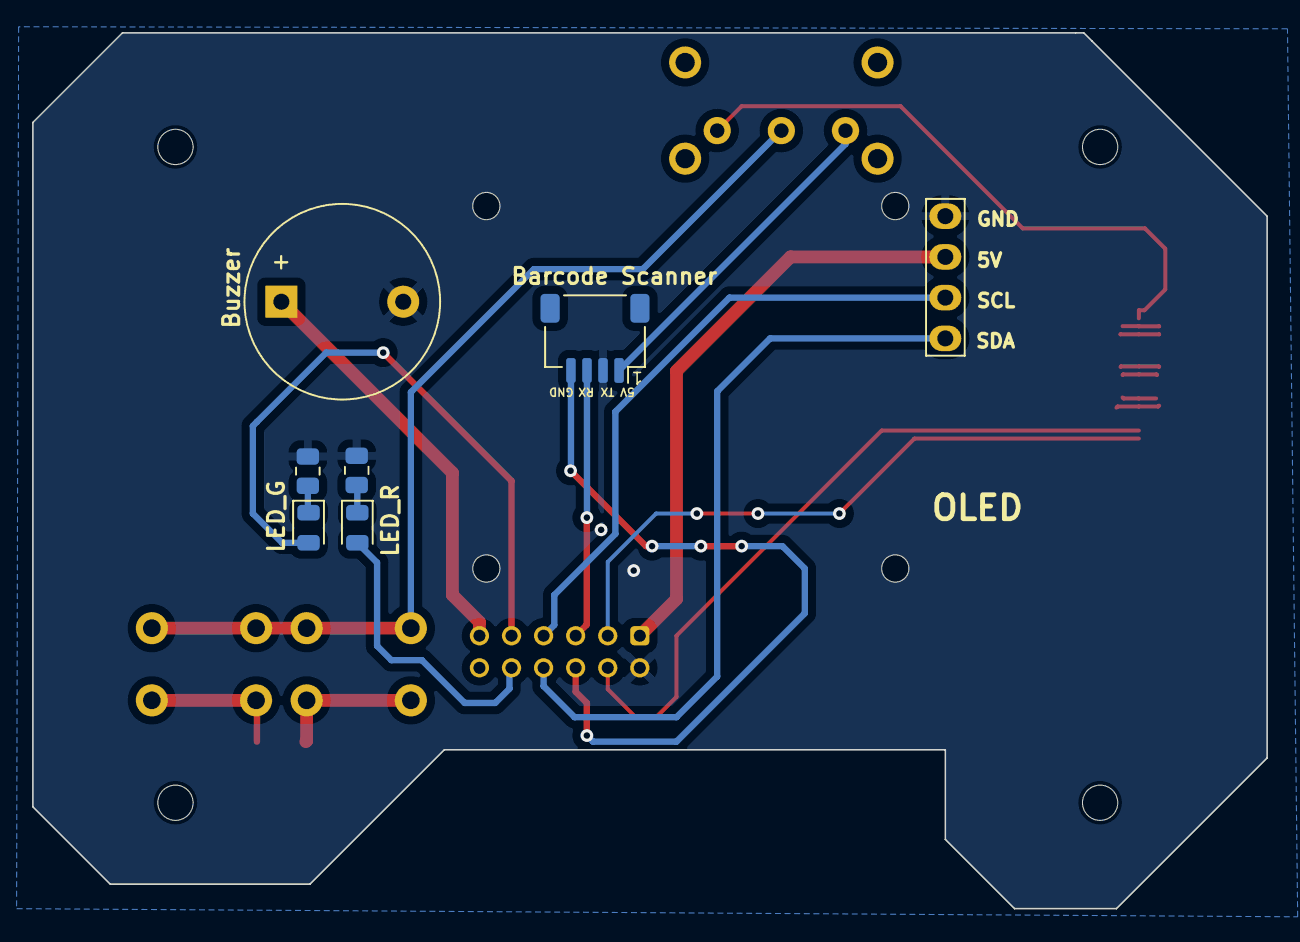
[picture p124: board WMS_PCB2.kicad_pcb from below]

Board: 2 copper layers, 77.0 x 54.6 mm, 18 parts (7 on the bottom side), 18 nets.

Parts:
BZ1: Buzzer; Buzzer_12x9.5RM7.6
Brd1: SSD1306; 128x64OLED_v2
D1, D2: LED; LED_0805_2012Metric
H5, H6, H7, H8: MountingHole; MountingHole_2.2mm_M2
J5: Conn_02x06_Odd_Even; JST_PHD_B12B-PHDSS_2x06_P2.00mm_Vertical
R1, R2, R3, R4: R; R_0805_2012Metric
SW1, SW3: SW_Push_Open; SW_PUSH_6mm_H9.5mm
SW4: SW_SPDT; SW_E-Switch_EG1224_SPDT_Angled
U4: GM67_Barcode_Scanner
U7: YR903_RFID_Scanner_FPC

Connections:
+5V: Brd1.2 (VCC), J5.1
/PCB1 : Subsistem Data Processing, Gateway, Power/POWER_BARCODE: SW4.3 (C), U4.1 (5V)
/PCB1 : Subsistem Data Processing, Gateway, Power/POWER_BUTTON_OUT: SW1.1 (A), SW3.1 (A), SW4.2 (B)
/PCB1 : Subsistem Data Processing, Gateway, Power/POWER_RFID: SW4.1 (A), U7.1 (VCC), U7.2 (VCC)
GND: BZ1.2 (-), Brd1.1 (GND), J5.2, R1.1, R2.1, R3.2, R4.2, U4.2 (GND), U7.3 (GND), U7.4 (GND), U7.8 (GND), U7.9 (GND), U7.12 (GND), U7.13 (GND)
unnamed: D1.1 (K), R1.2
unnamed: D2.1 (K), R2.2
P6_0: Brd1.3 (SCL), J5.7
P6_1: Brd1.4 (SDA), J5.8
P9_0: J5.6, U4.4 (RX)
P9_1: J5.5, U4.3 (TX)
P9_2: D1.2 (A), J5.9
P9_4: D2.2 (A), J5.10
P12_0: J5.3, U7.17 (TXD)
P12_1: J5.4, U7.16 (RXD)
P12_3: BZ1.1 (+), J5.11
P13_4: R3.1, SW1.2 (B)
P13_6: R4.1, SW3.2 (B)
