bostang/PSoC6/Development/DataAcquisition_and_Processing/data_acquisition.h

#define RX_BUF_SIZE     4
#define TX_BUF_SIZE     13
//#define TX_BUF_SIZE     14
//#define TX_BUF_SIZE     5

//uint8_t data_acquisition_task(void *arg);
//uint8_t* data_acquisition_task(void *arg);
uint8_t* data_acquisition_task();
