bostang/PSoC6/(commit log)

2023-12-03 + GPIO project
    mampu mengendalikan pushbutton dan LED (GPIO) dengan mengikuti example code GPIO
2023-12-06 +TestUART
    Kode untuk mengetes Barcode scanner pada Arduino UNO
2023-12-06 +test RFID
    kode untuk menggunakan RFID pada ESP32 dan menampilkannya pada Serial monitor
2023-12-09 +ReceiveUART
    Mengetikkan karakter pada keyboard lalu mengirimkan ke USB-TTL (dilihat di terminal baru)
2023-12-09 +TransmitnReceive
    Membuat dua objek UART. Mengirimkan data dari barcode scanner dan membaca pada USB-TTL
2023-12-11 +RFID_UART
    memulai projek membaca RFID (UART) dengan PSoC6
2023-12-11 + FeeRTOS Example
    menambahkan contoh membuat task dengan FreeRTOS untuk blinking LED
2023-12-14 UART_arbitrary_pin
    Menggunakan UART di pin sembarang
2023-12-15 +Arduino_RFIDStartRead.ino
    Program untuk ESP32 yang dibuat di Arduino IDE untuk memverifikasi bahwa ketika perintah (bytes) start read dikirim, maka LED pada RFID interface menyala dan ketika perintah (bytes) stop read dikirim, maka LED pada RFID interface mati.
2023-12-16 +BUG_RFIDStartRead.c
    Menambahkan program (masih belum berhasil) untuk memulai mode baca pada RFID interface dengan PSoC
    [BUG_RFIDStartRead.c]
2023-12-16 Create Arduino_RFID_StartRead
    + versi tanpa guru meditation error
2023-12-16 Create Arduino_testLCD16x2.ino
    Pengujian LCD16x2 pada ESP32
2023-12-16 Create test_buzzer.ino
    Melakukan pengujian terhadap buzzer berbunyi
    [test_buzzer.ino]
2024-03-05 +PCB_v1
    menambahkan desain skematik PCB menggunakan kicad
    [DataAcquisition.kicad_sch, Display.kicad_sch, PCB1_DataProc_Power_Gateway.kicad_sch, PCB2_DataAcq_Display.kicad_sch, PSoC.kicad_sch, Power.kicad_sch, WMS.kicad_pcb, WMS.kicad_sch]
2024-03-06 +Update PCB (v.1)
    membuat PCB versi 1
    [DataAcquisition.kicad_sch, Display.kicad_sch, PCB1_DataProc_Power_Gateway.kicad_sch, PCB2_DataAcq_Display.kicad_sch, PSoC.kicad_sch, Power.kicad_sch, WMS.kicad_pcb, WMS.kicad_sch]
2024-03-13 + baca RFID module YR903 dengan esp32
2024-03-14 +YR903
    pengembangan YR903 (memulai)
    [12mm Push Button Cap.IGS, 12mm Push Button Cap.SLDPRT, 12mm Push Button Cap.STEP, 12mm Push Button with Cap.IGS, 12mm Push Button with Cap.SLDASM, 12mm Push Button with Cap.STEP, 12mm Push Button.IGS, 12mm Push Button.SLDPRT]
2024-03-14 +YR903 rfid development
    pengembangan modul rfid scanner rfid yr903
    [DataAcquisition.kicad_sch, Display.kicad_sch, PCB1_DataProc_Power_Gateway.kicad_sch, PCB2_DataAcq_Display.kicad_sch, PSoC.kicad_sch, Power.kicad_sch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]
2024-03-26 +update PCBv2_print
    menambahkan file PCB v2 untuk dicetak
    [DataAcquisition.kicad_sch, Display.kicad_sch, PCB1_DataProc_Power_Gateway.kicad_sch, PCB2_DataAcq_Display.kicad_sch, PSoC.kicad_sch, Power.kicad_sch, WMS - Copy.kicad_sch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]
2024-04-19 +kode development integrasi
    [2-1734592-0.stp, 5mm DPDT Mini Toggle Switch.FCStd, 5mm DPDT Mini Toggle Switch.step, 6mm DPDT Mini Toggle Switch.FCStd, 6mm DPDT Mini Toggle Switch.step, 6mm SPDT Mini Toggle Switch.FCStd, 6mm SPDT Mini Toggle Switch.step, BM02B-SRSS-TB.STEP]
2024-04-24 fix integrasi 5 & 6
    [led.h, main.c, oled.h]
2024-06-14 final version of PCB
